GeorgeChiou/MiniPlan-V5/3D Mould Part/DOC/Print Part Group 12.JPG

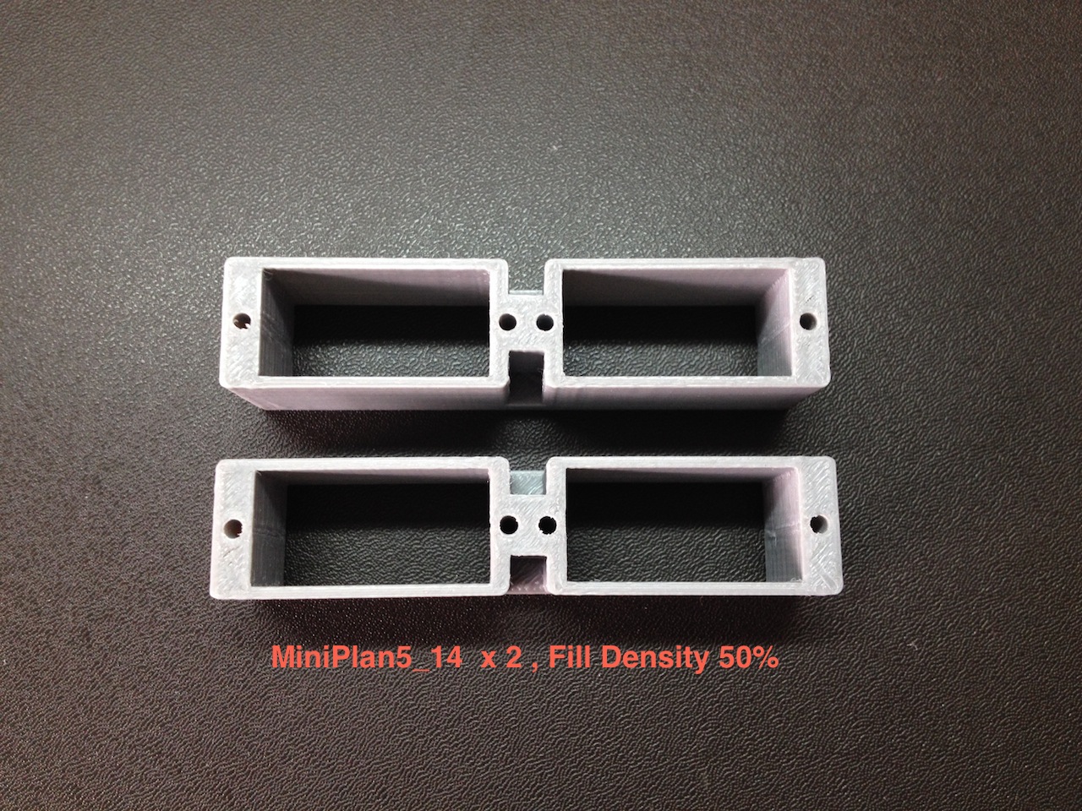
3D Mould Part/DOC/Print Part Group 12.JPG
