GeorgeChiou/MiniPlan-V5/3D Mould Part/DOC/MiniPlan v5.1 3DP for Iron Man.pdf

| 圖片 | 檔案名稱 | 數量
☐ | | MiniPlan5_10 | 14
☐ | | MiniPlan5_11 | 6
☐ | | MiniPlan5_12 | 1
☐ | | MiniPlan5_13 | 1
☐ | | MiniPlan5_14 | 2
☐ | | MiniPlan5_21 | 8
☐ | | MiniPlan5_25 | 2
☐ | | MiniPlan5_27 | 2
☐ | | MiniPlan5_30 | 1
☐ | | MiniPlan5_32 | 1
☐ | | MiniPlan5_40 | 1
☐ | | MiniPlan5_42 | 1
☐ | | MiniPlan5_43 | 1

☐ | MiniPlan5_50 | 1
☐ | MiniPlan5_51 | 1
☐ | MiniPlan51_20 | 8
☐ | MiniPlan51_22 | 4
☐ | MiniPlan51_23 | 2

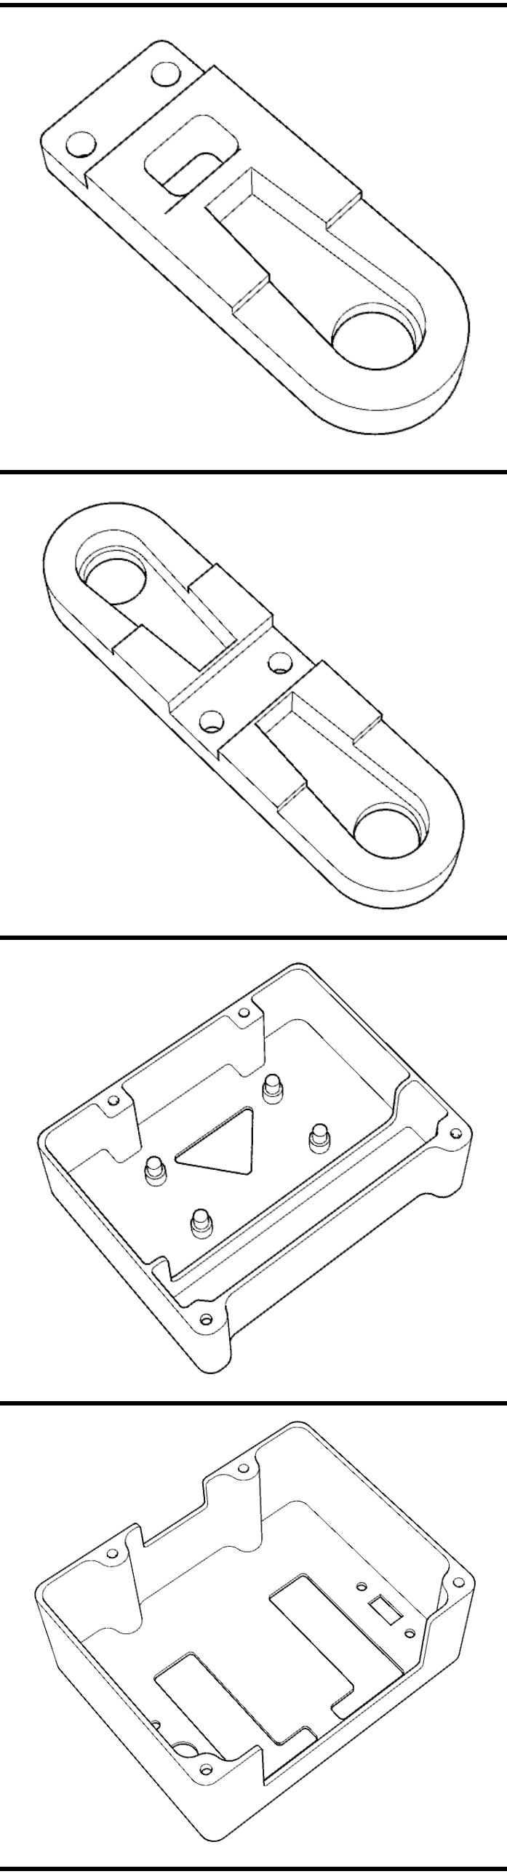
[picture p3: figure]

☐ | MiniPlan51_24 | 2
☐ | MiniPlan51_26 | 2
☐ | MiniPlan51_31_B | 1
☐ | MiniPlan51_34 | 1
☐ | MiniPlan51_60 | 1
☐ | MiniPlan51_61 | 1

☐ | MiniPlan51_70 | 2
☐ | MiniPlan51_71（透明材料） | 1
