GeorgeChiou/MiniPlan-V5/3D Mould Part/DOC/Arm.png

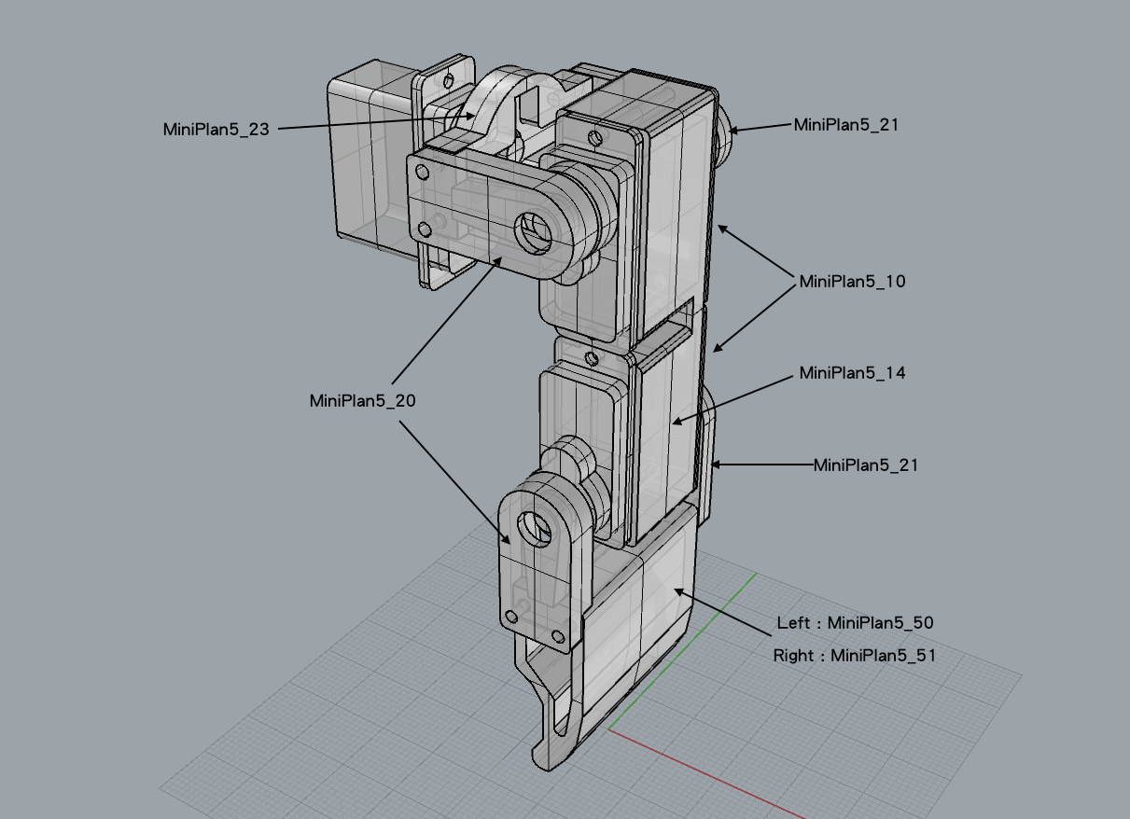
3D Mould Part/DOC/Arm.png
