GeorgeChiou/MiniPlan-V5/3D Mould Part/DOC/Body.png

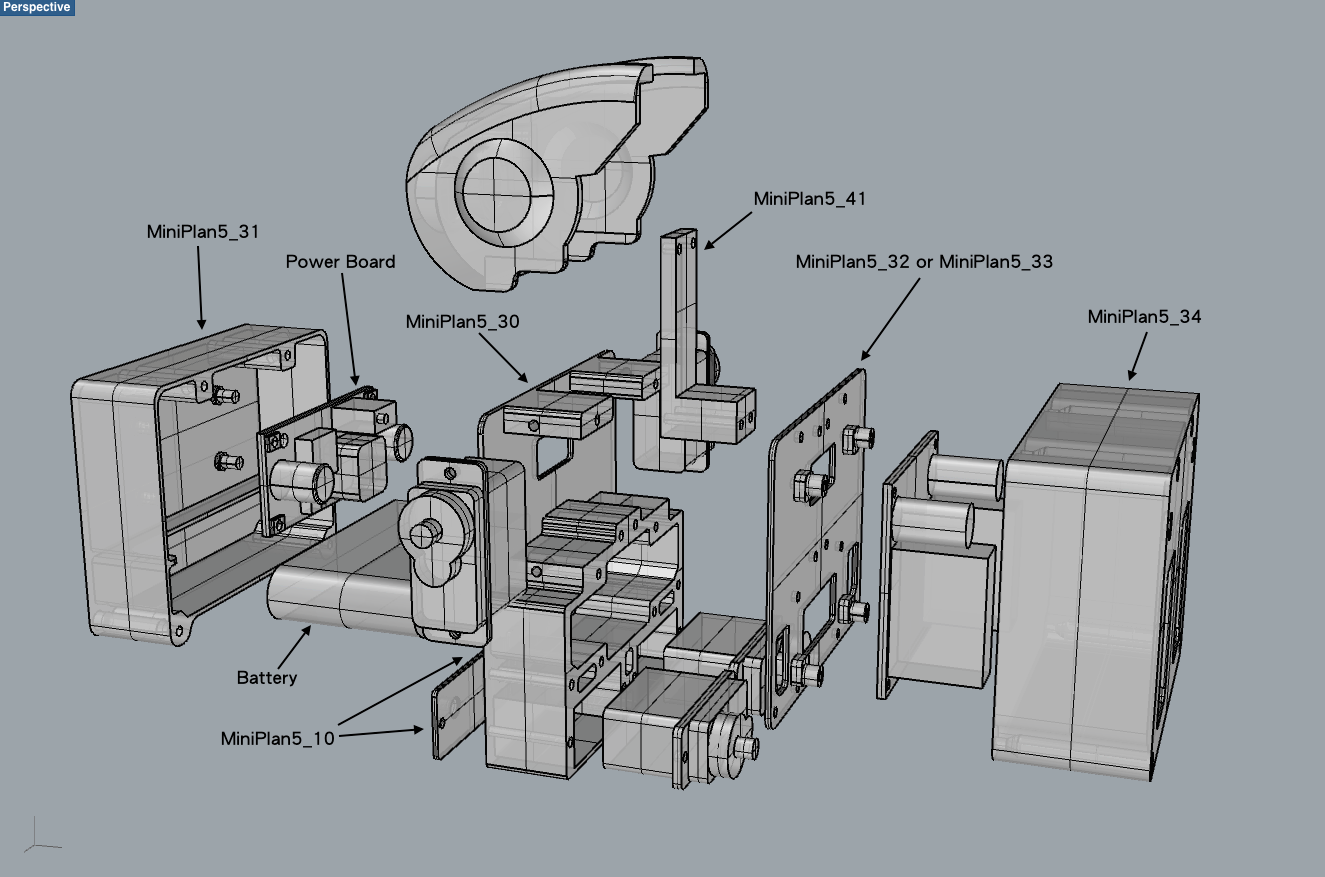
3D Mould Part/DOC/Body.png
