GeorgeChiou/MiniPlan-V5/3D Mould Part/DOC/CheckPart1.JPG

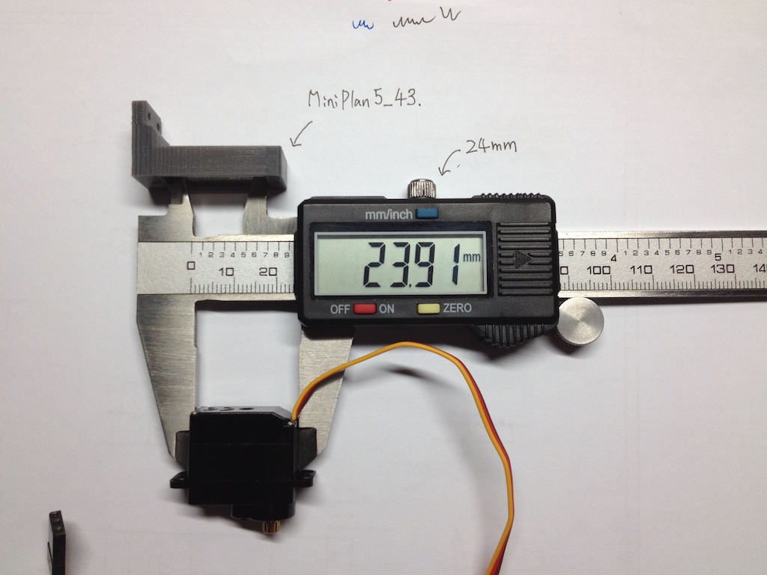
3D Mould Part/DOC/CheckPart1.JPG
