GeorgeChiou/MiniPlan-V5/3D Mould Part/DOC/CheckPart2.JPG

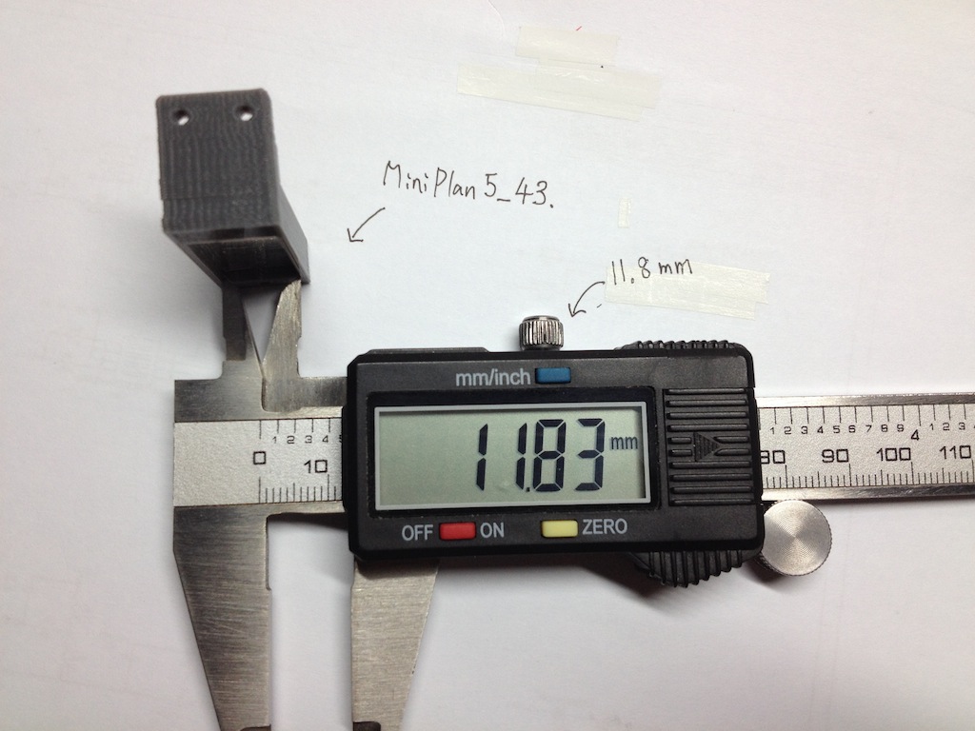
3D Mould Part/DOC/CheckPart2.JPG
