GeorgeChiou/MiniPlan-V5/3D Mould Part/DOC/Color Paint 1.png

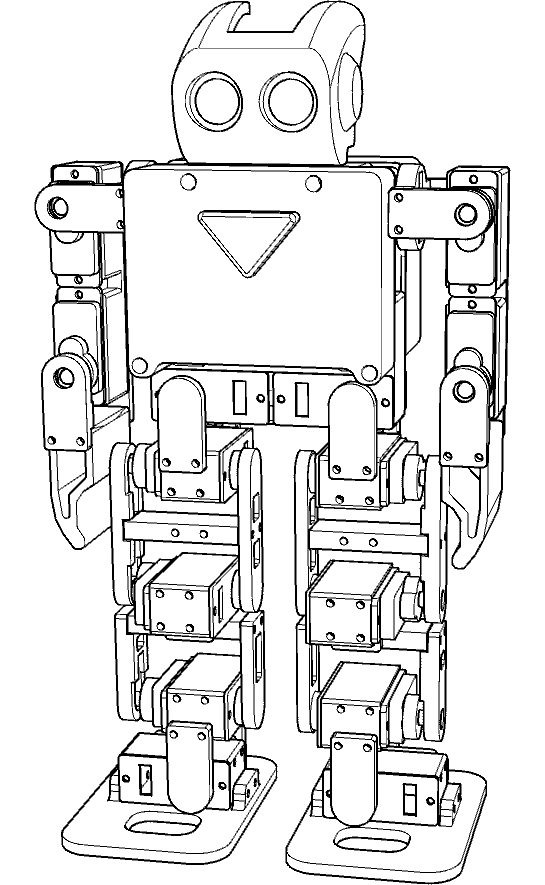
3D Mould Part/DOC/Color Paint 1.png
