GeorgeChiou/MiniPlan-V5/3D Mould Part/DOC/Color Paint 2.png

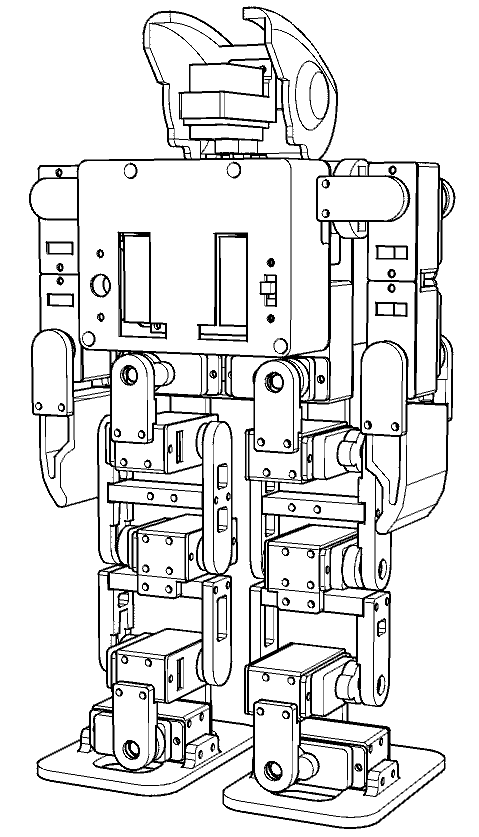
3D Mould Part/DOC/Color Paint 2.png
