GeorgeChiou/MiniPlan-V5/3D Mould Part/DOC/Cura 1.png

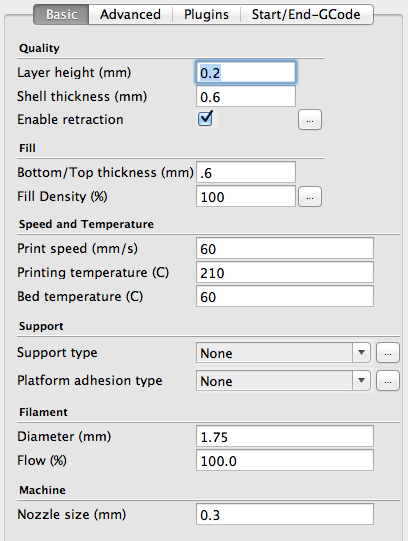
3D Mould Part/DOC/Cura 1.png
