GeorgeChiou/MiniPlan-V5/3D Mould Part/DOC/Cura 2.png

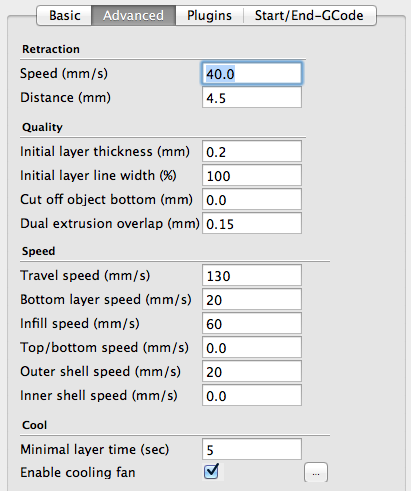
3D Mould Part/DOC/Cura 2.png
