GeorgeChiou/MiniPlan-V5/3D Mould Part/DOC/Head.png

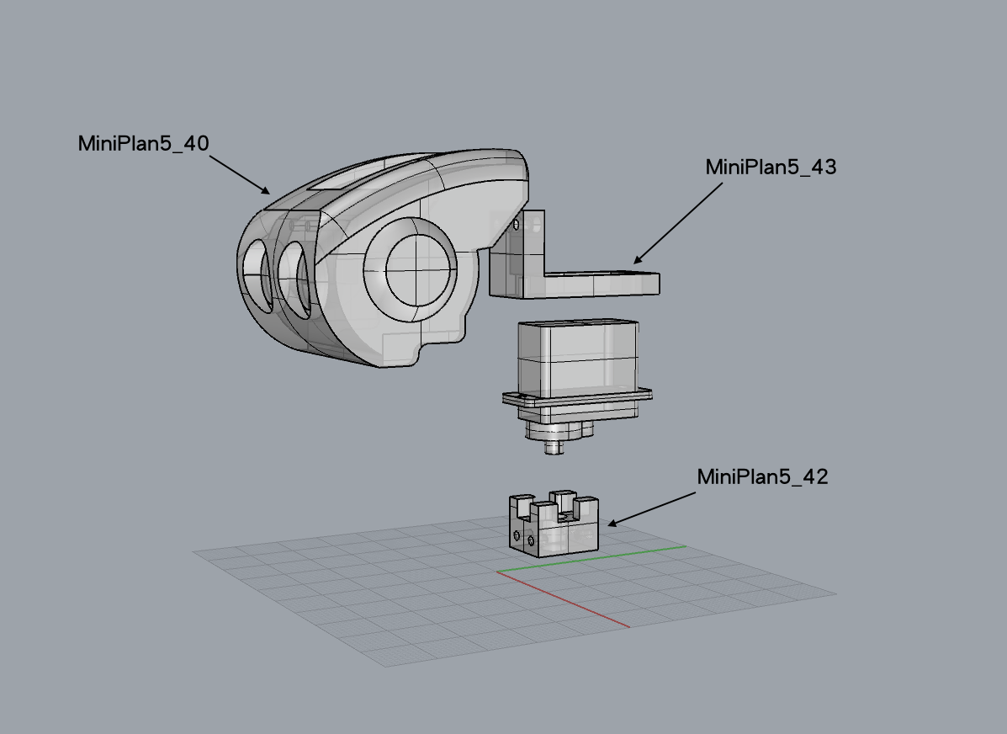
3D Mould Part/DOC/Head.png
