GeorgeChiou/MiniPlan-V5/3D Mould Part/DOC/Leg.png

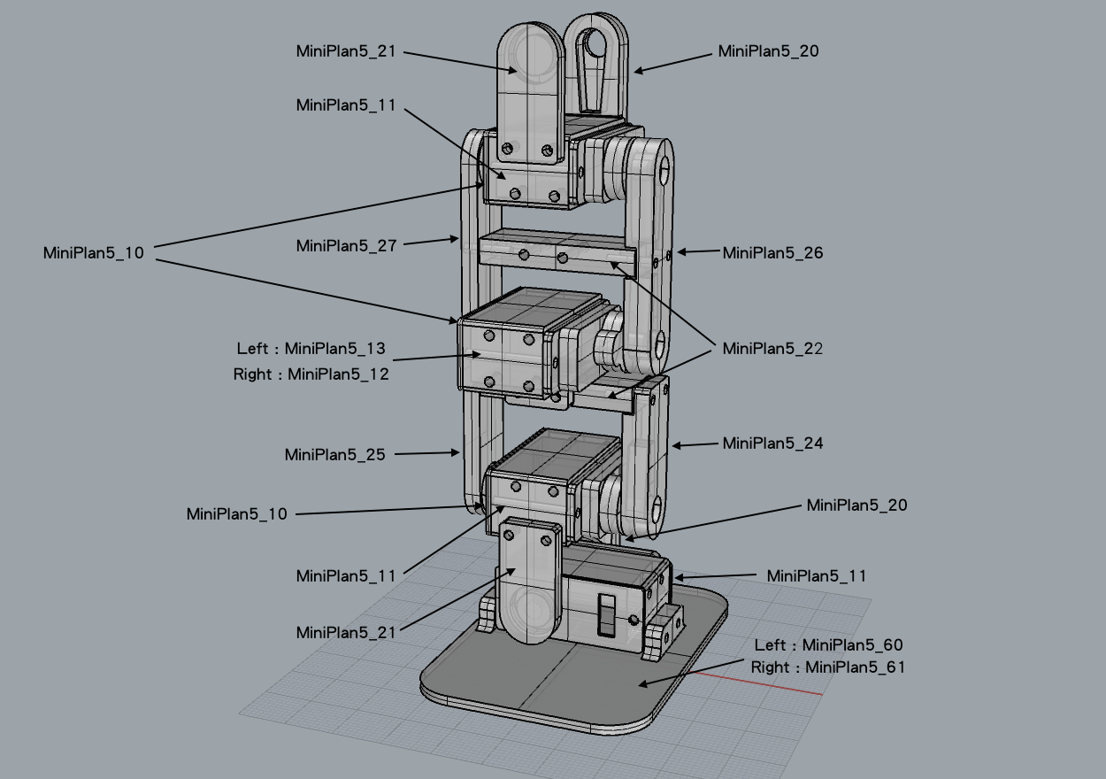
3D Mould Part/DOC/Leg.png
