GeorgeChiou/MiniPlan-V5/MiniPlan v5.1 HDK Part List.pdf

零件預覽 | 零件名稱 | 數量

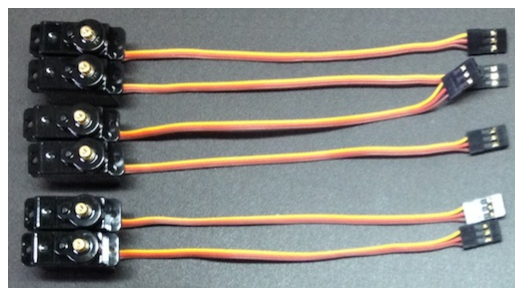
[picture p14: figure]

| 線長 13cm 伺服馬達 與配件包 | 6 包

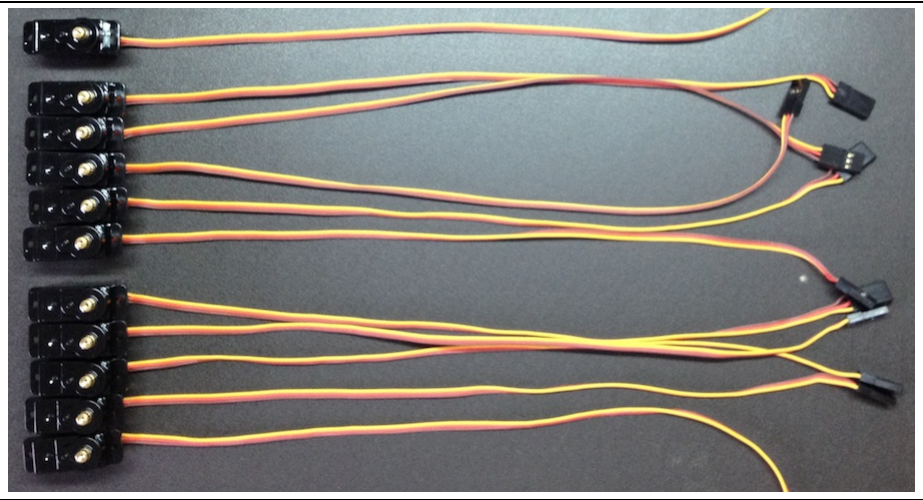
[picture p15: figure]

| 線長 25cm 伺服馬達 與配件包 | 11 包

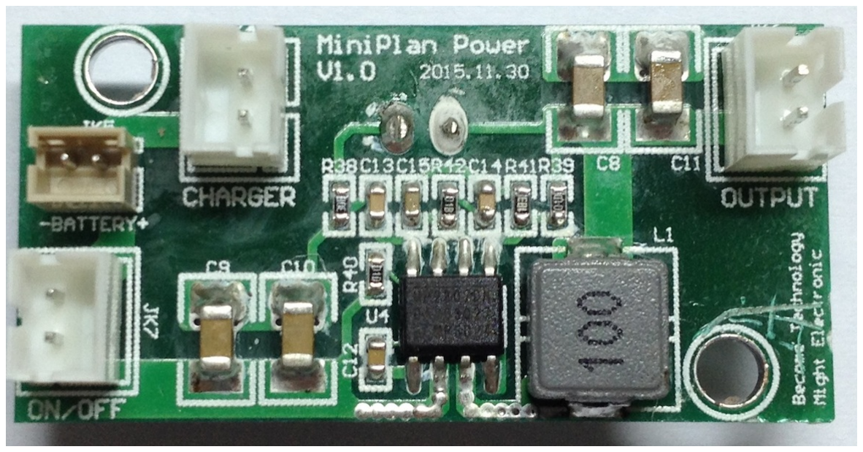
[picture p16: figure]

| 電源板 與 3mm LED | 1 片 1 顆

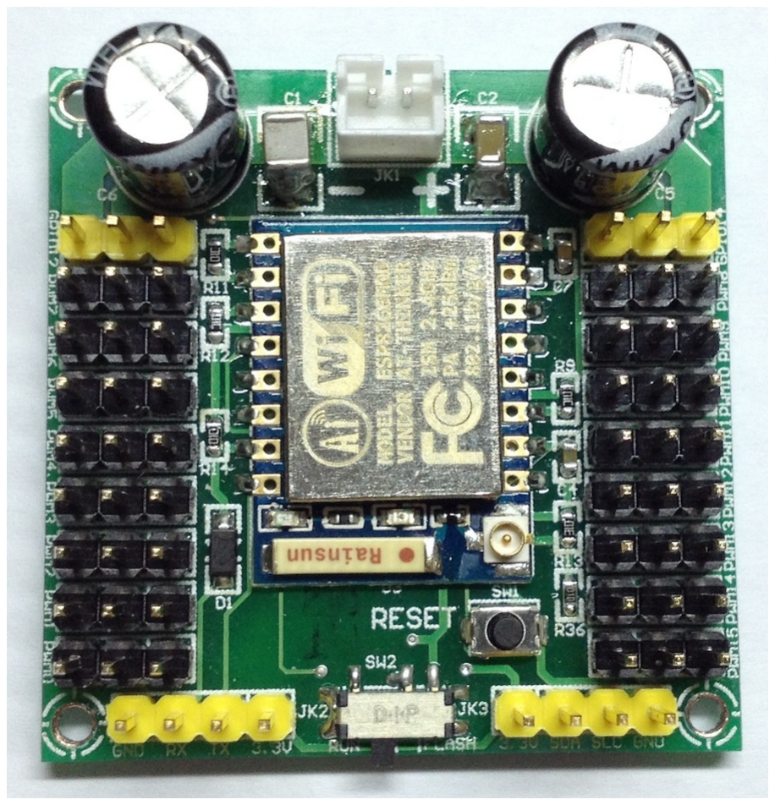
[picture p17: figure]

主控制板 | 1 片

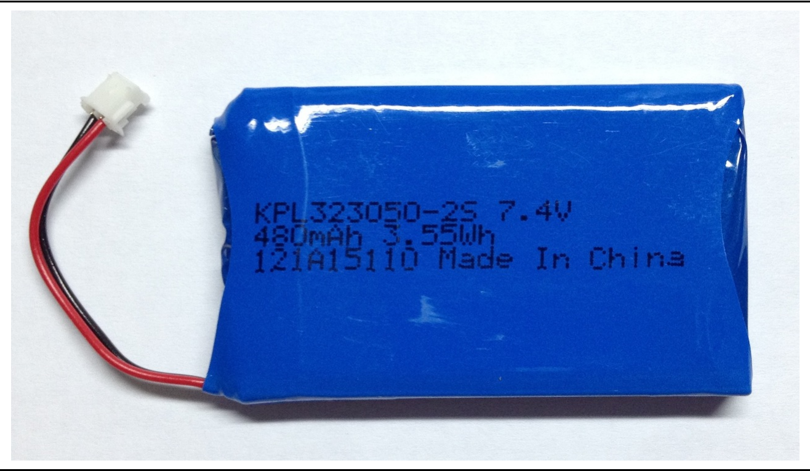
[picture p18: figure]

鋰電池 | 1 個

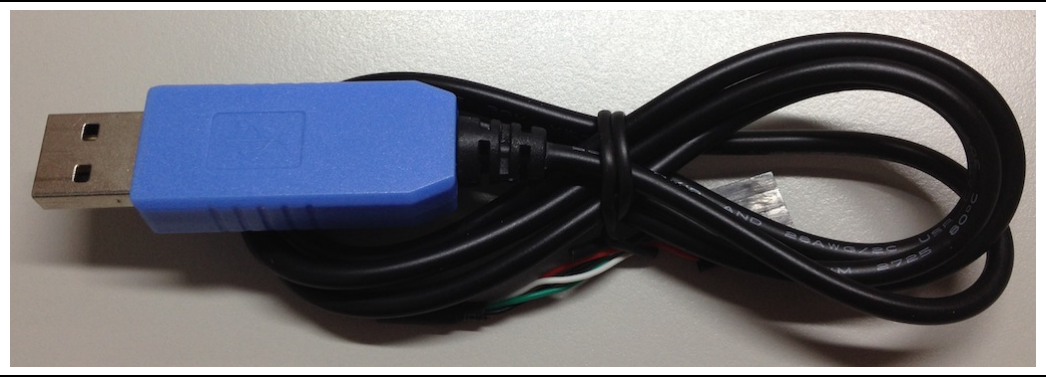
[picture p19: figure]

PL2303TA 電壓 3.3V TTL 傳輸線 USB to | 1 條

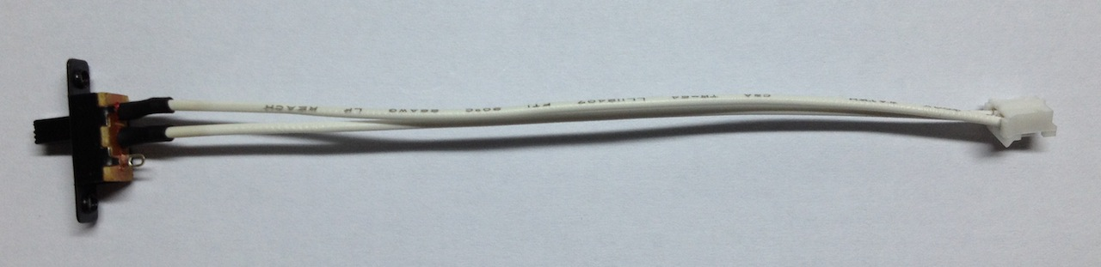
[picture p20: figure]

開關線組 | 1 條

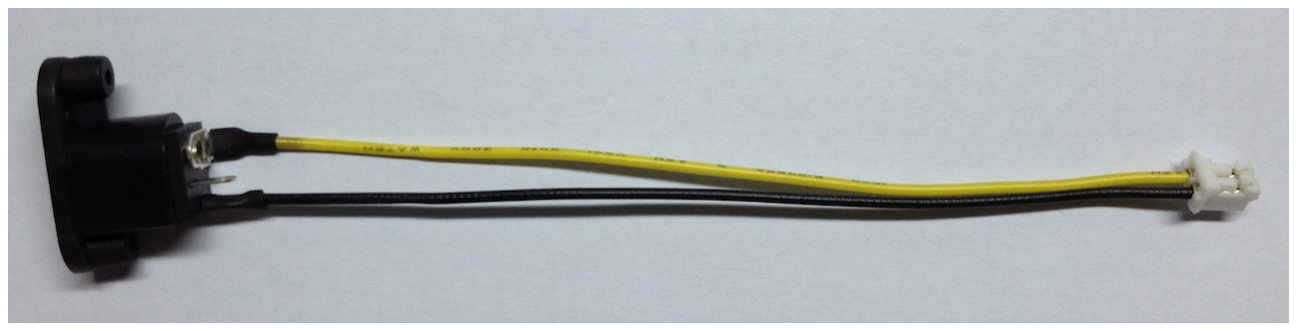
[picture p21: figure]

充電線組 | 1 條

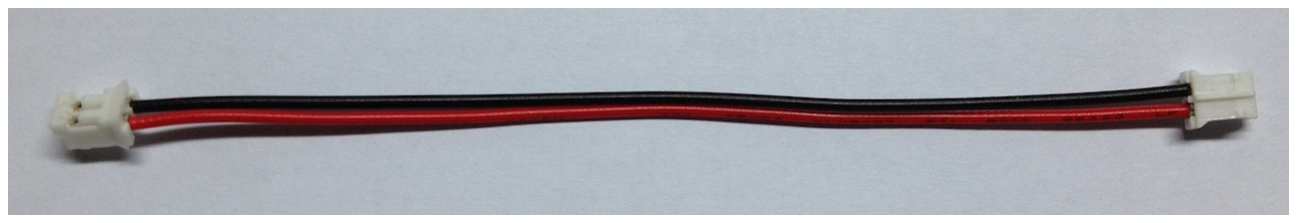
[picture p22: figure]

電源線組 | 1 條
培林 | 14 顆
8mm 自攻螺絲 2mm x | 200 顆
