GeorgeChiou/MiniPlan-V5/3D Mould Part/MiniPlan5_Leg_Assembly.stl

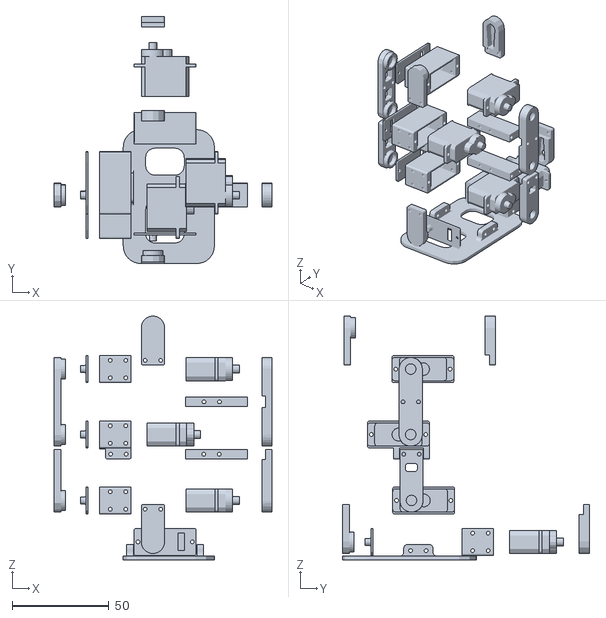
[picture p23: CAD file, 2018-02-11]
3D Mould Part/MiniPlan5_Leg_Assembly.stl
112.3 x 127.3 x 125.7
