GeorgeChiou/MiniPlan-V5/3D Mould Part/MiniPlan5_Head_Assembly_A.stl

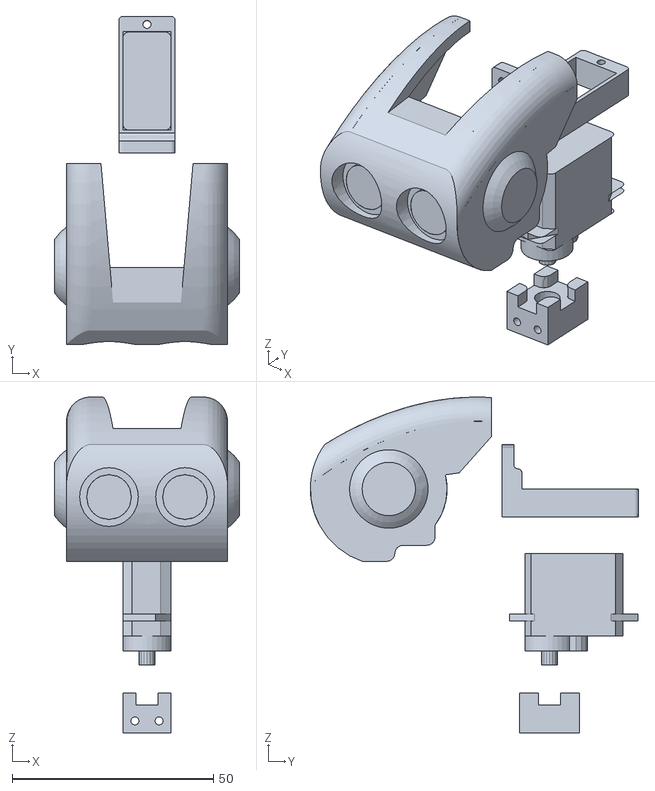
[picture p24: CAD file, 2018-02-11]
3D Mould Part/MiniPlan5_Head_Assembly_A.stl
46.0 x 81.6 x 83.5
