GeorgeChiou/MiniPlan-V5/3D Mould Part/MiniPlan5_Arm_FullAssembly.stl

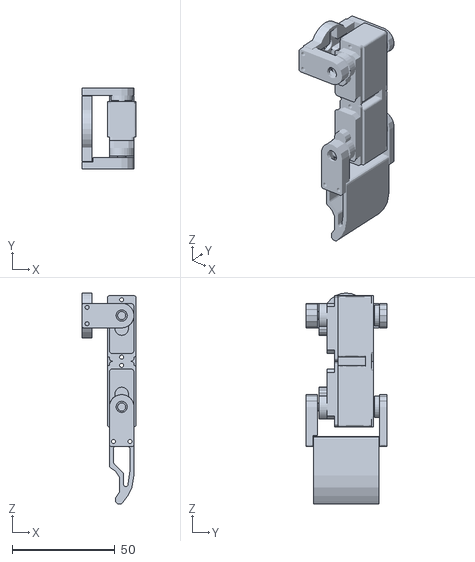
[picture p25: CAD file, 2018-02-11]
3D Mould Part/MiniPlan5_Arm_FullAssembly.stl
26.4 x 39.3 x 102.9
