GeorgeChiou/MiniPlan-V5/3D Mould Part/MiniPlan5_Arm_Assembly.stl

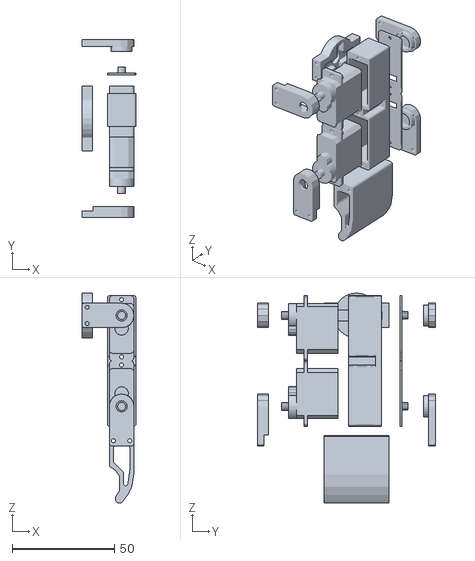
[picture p26: CAD file, 2018-02-11]
3D Mould Part/MiniPlan5_Arm_Assembly.stl
26.4 x 87.3 x 102.9
