GeorgeChiou/MiniPlan-V5/3D Mould Part/MiniPlan5_Body_Assembly.stl

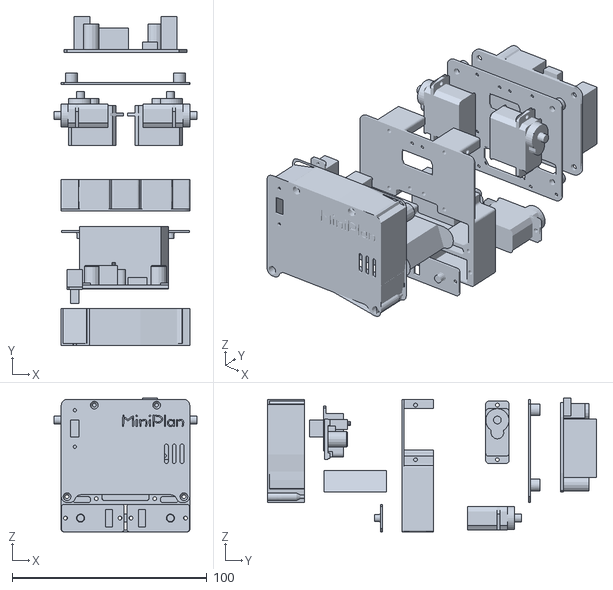
[picture p27: CAD file, 2018-02-11]
3D Mould Part/MiniPlan5_Body_Assembly.stl
73.4 x 168.9 x 68.5
