GeorgeChiou/MiniPlan-V5/3D Mould Part/MiniPlan5_Head_Assembly_B.stl

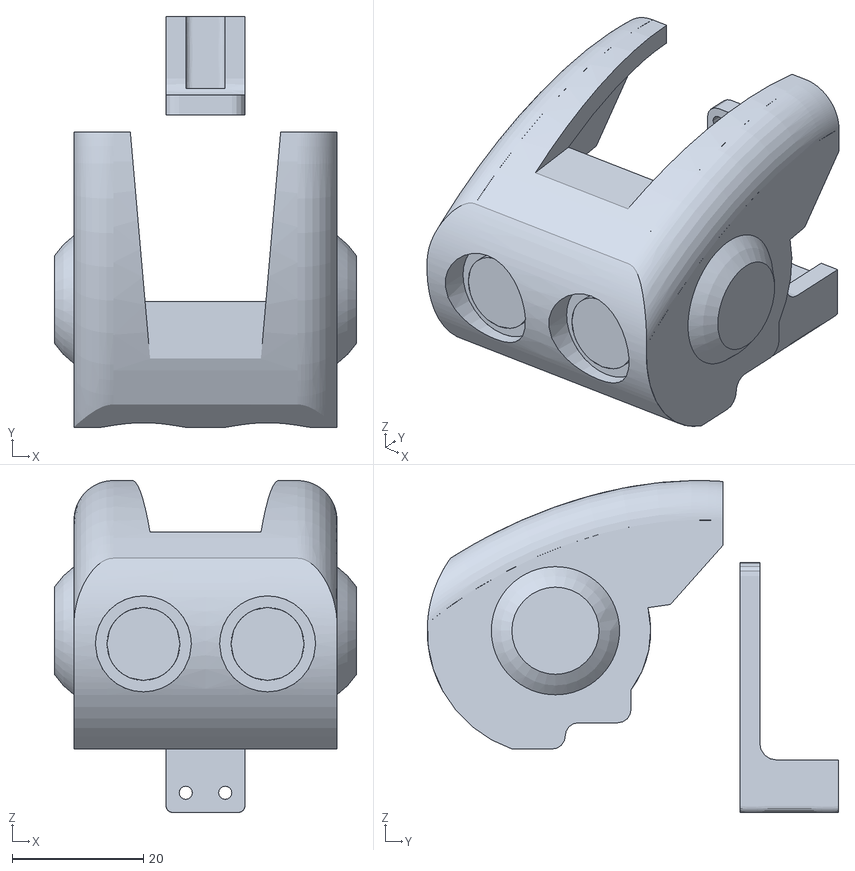
[picture p28: CAD file, 2018-02-11]
3D Mould Part/MiniPlan5_Head_Assembly_B.stl
46.0 x 62.6 x 50.5
