GeorgeChiou/MiniPlan-V5/3D Mould Part/MiniPlan5_Leg_FullAssembly.stl

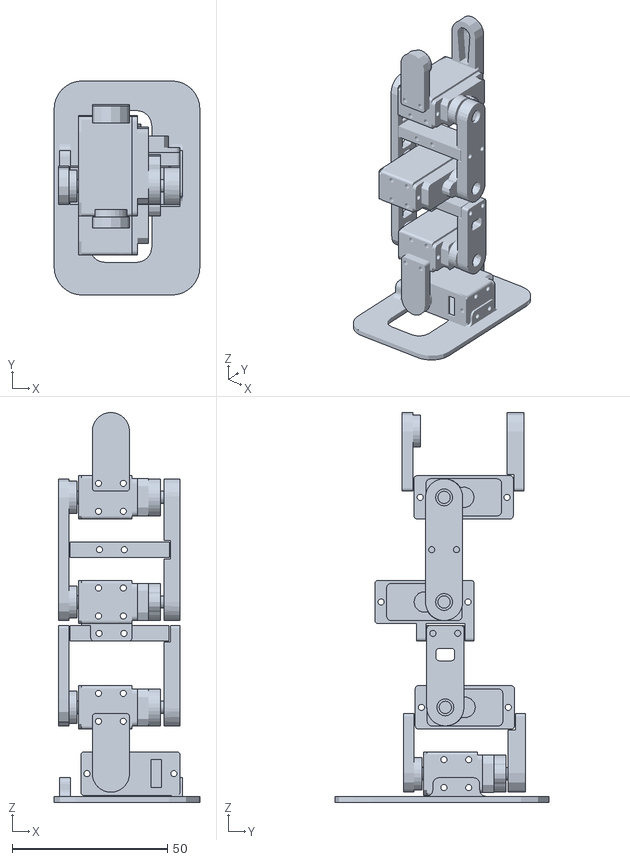
[picture p29: CAD file, 2018-02-11]
3D Mould Part/MiniPlan5_Leg_FullAssembly.stl
47.0 x 69.0 x 125.7
