GeorgeChiou/MiniPlan-V5/3D Mould Part/Arms Parts/MiniPlan5_50.stl

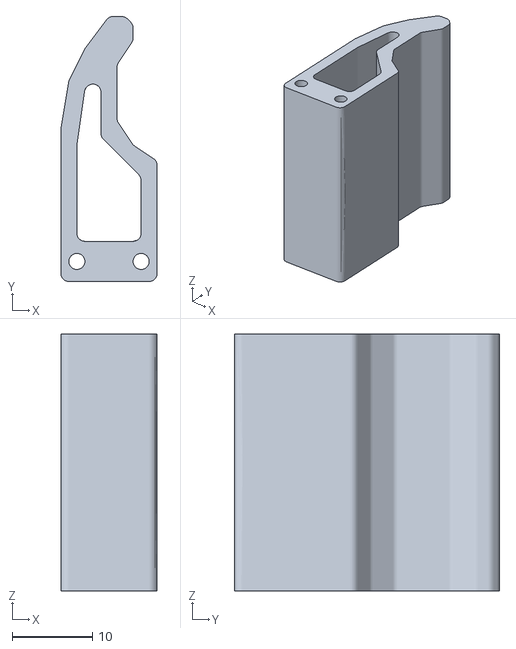
[picture p30: CAD file, 2018-02-11]
3D Mould Part/Arms Parts/MiniPlan5_50.stl
12.0 x 33.0 x 32.0
