GeorgeChiou/MiniPlan-V5/3D Mould Part/Body Parts/MiniPlan5_10.stl

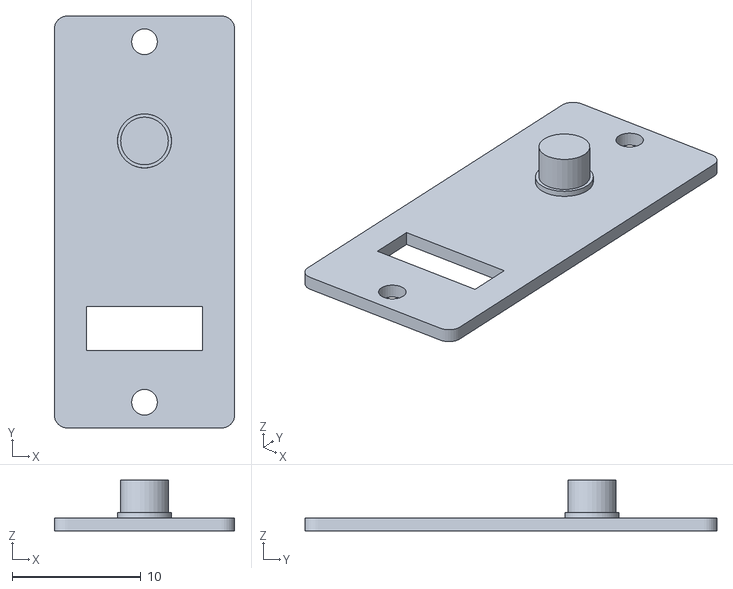
[picture p31: CAD file, 2018-02-11]
3D Mould Part/Body Parts/MiniPlan5_10.stl
14.0 x 32.0 x 3.95
