GeorgeChiou/MiniPlan-V5/3D Mould Part/Head Parts FIX/MiniPlan51_70.stl

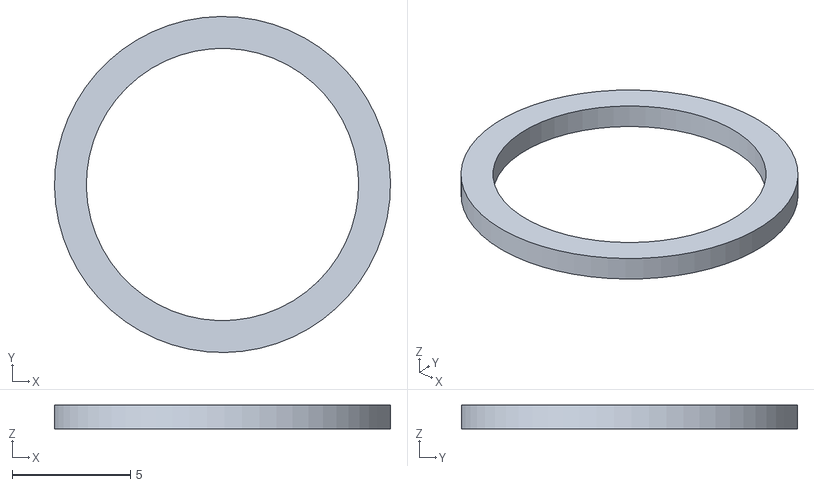
[picture p32: CAD file, 2018-02-11]
3D Mould Part/Head Parts FIX/MiniPlan51_70.stl
14.2 x 14.2 x 1.00
