GeorgeChiou/MiniPlan-V5/3D Mould Part/Head Parts MOVE/MiniPlan5_40.stl

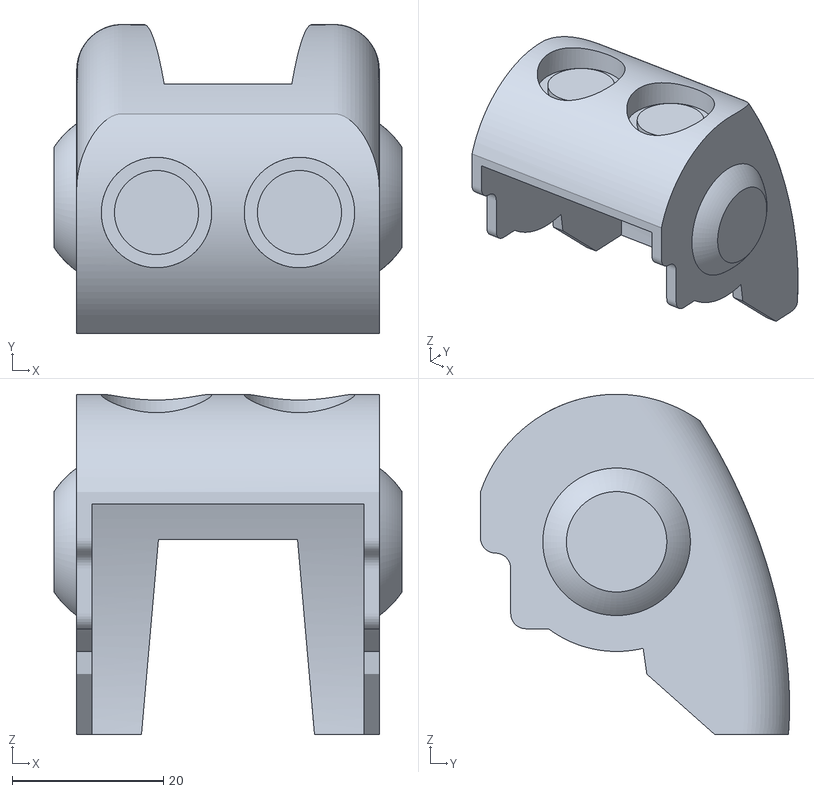
[picture p33: CAD file, 2018-02-11]
3D Mould Part/Head Parts MOVE/MiniPlan5_40.stl
46.0 x 40.9 x 45.0
