GeorgeChiou/MiniPlan-V5/3D Mould Part/Iron Man Body Parts/MiniPlan51_31_B.stl

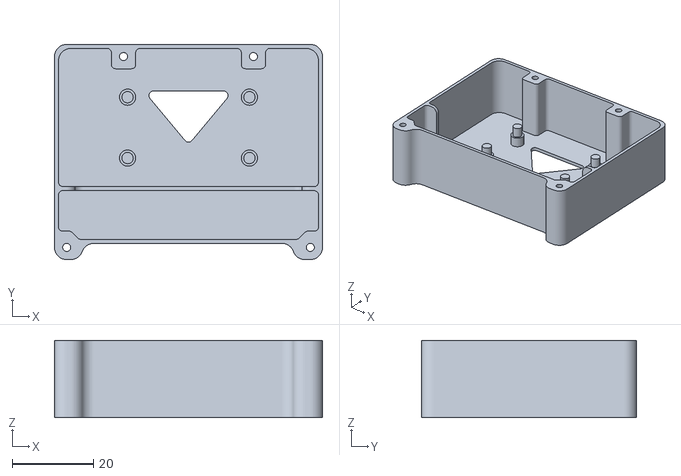
[picture p34: CAD file, 2018-02-11]
3D Mould Part/Iron Man Body Parts/MiniPlan51_31_B.stl
66.0 x 53.0 x 19.0
