GeorgeChiou/MiniPlan-V5/3D Mould Part/Left Leg Parts/MiniPlan51_24.stl

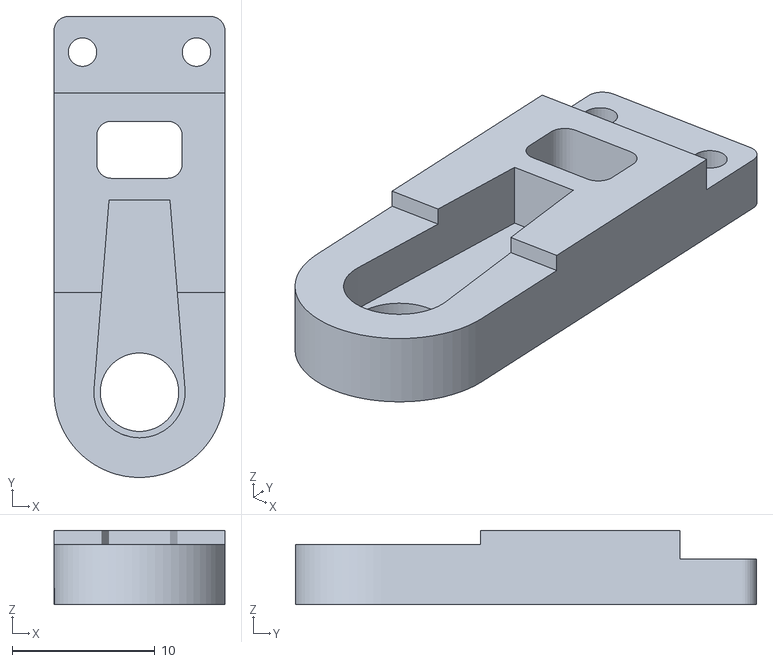
[picture p35: CAD file, 2018-02-11]
3D Mould Part/Left Leg Parts/MiniPlan51_24.stl
12.0 x 32.4 x 5.20
