GeorgeChiou/MiniPlan-V5/3D Mould Part/Right Leg Parts/MiniPlan51_20.stl

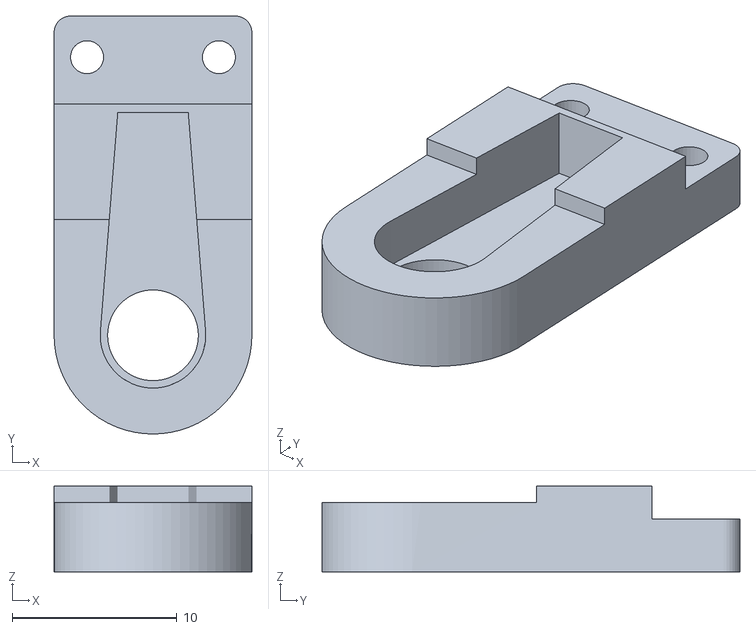
[picture p36: CAD file, 2018-02-11]
3D Mould Part/Right Leg Parts/MiniPlan51_20.stl
12.0 x 25.4 x 5.20
