GeorgeChiou/MiniPlan-V5/3D Mould Part/Arms Parts/MiniPlan5_14.stl

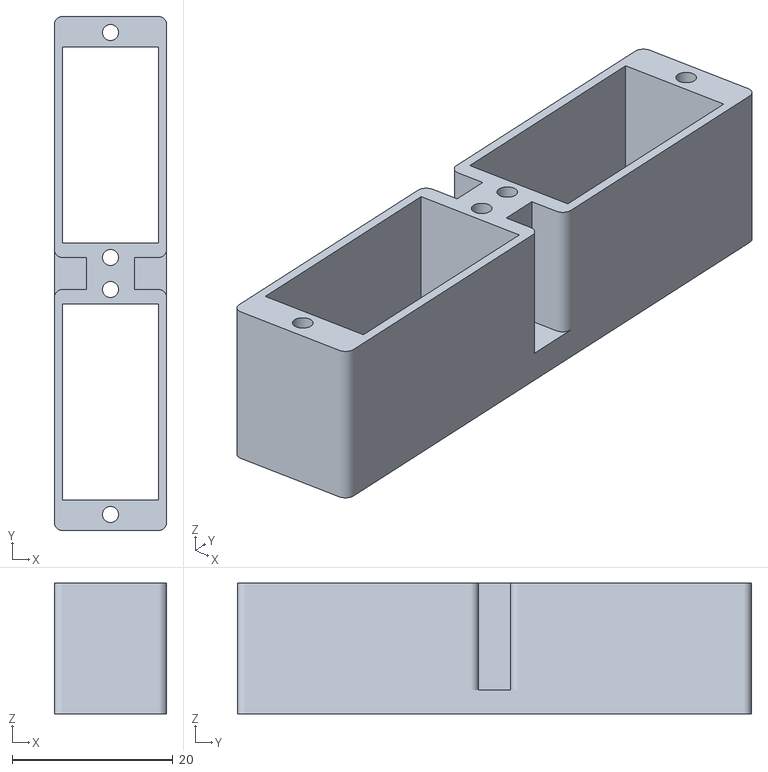
[picture p37: CAD file, 2018-02-11]
3D Mould Part/Arms Parts/MiniPlan5_14.stl
14.0 x 64.0 x 16.3
