GeorgeChiou/MiniPlan-V5/3D Mould Part/Body Parts/MiniPlan5_32.stl

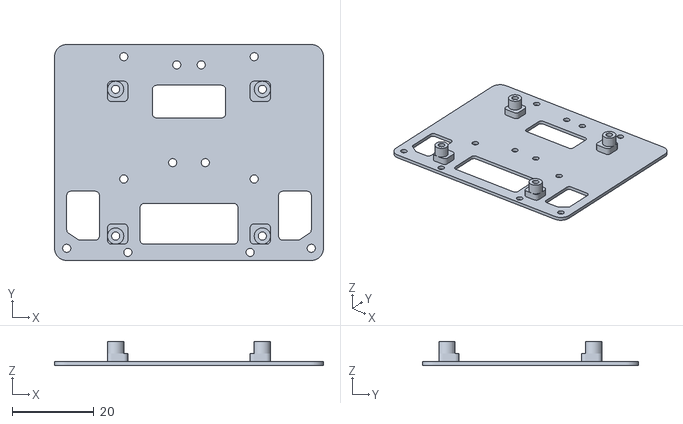
[picture p38: CAD file, 2018-02-11]
3D Mould Part/Body Parts/MiniPlan5_32.stl
66.0 x 53.0 x 6.00
