GeorgeChiou/MiniPlan-V5/3D Mould Part/Head Parts FIX/MiniPlan5_41.stl

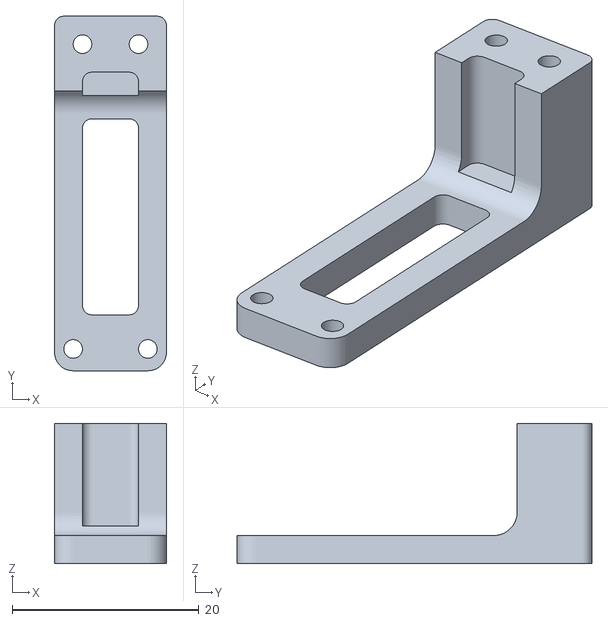
[picture p39: CAD file, 2018-02-11]
3D Mould Part/Head Parts FIX/MiniPlan5_41.stl
12.0 x 38.0 x 15.0
