GeorgeChiou/MiniPlan-V5/3D Mould Part/Right Leg Parts/MiniPlan51_61.stl

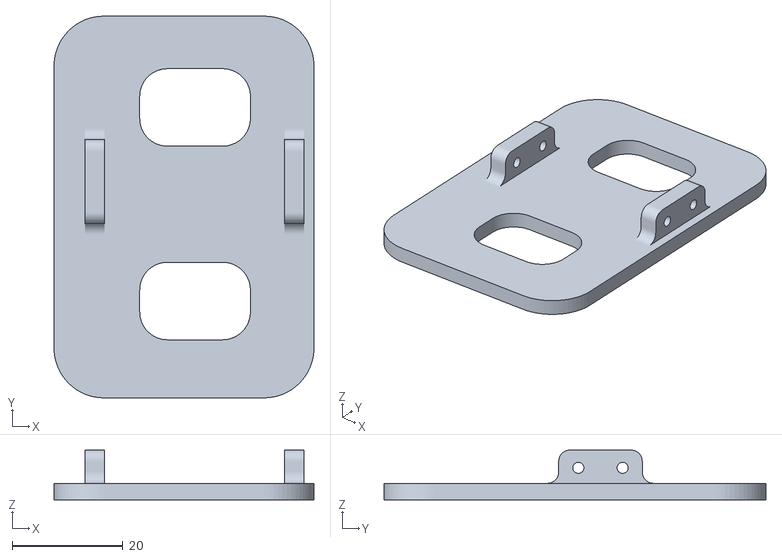
[picture p41: CAD file, 2018-02-11]
3D Mould Part/Right Leg Parts/MiniPlan51_61.stl
47.0 x 69.0 x 9.00
