GeorgeChiou/MiniPlan-V5/3D Mould Part/Body Parts/MiniPlan5_33.stl

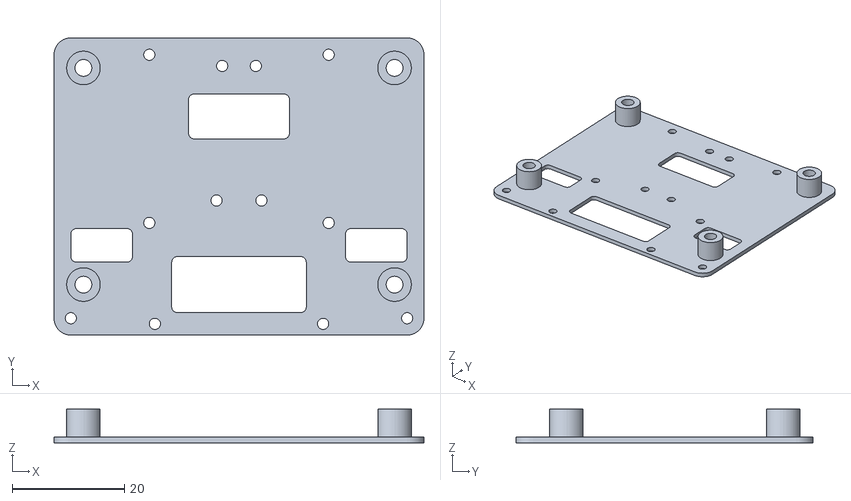
[picture p42: CAD file, 2018-02-11]
3D Mould Part/Body Parts/MiniPlan5_33.stl
66.0 x 53.0 x 6.00
