GeorgeChiou/MiniPlan-V5/3D Mould Part/Head Parts MOVE/MiniPlan5_43.stl

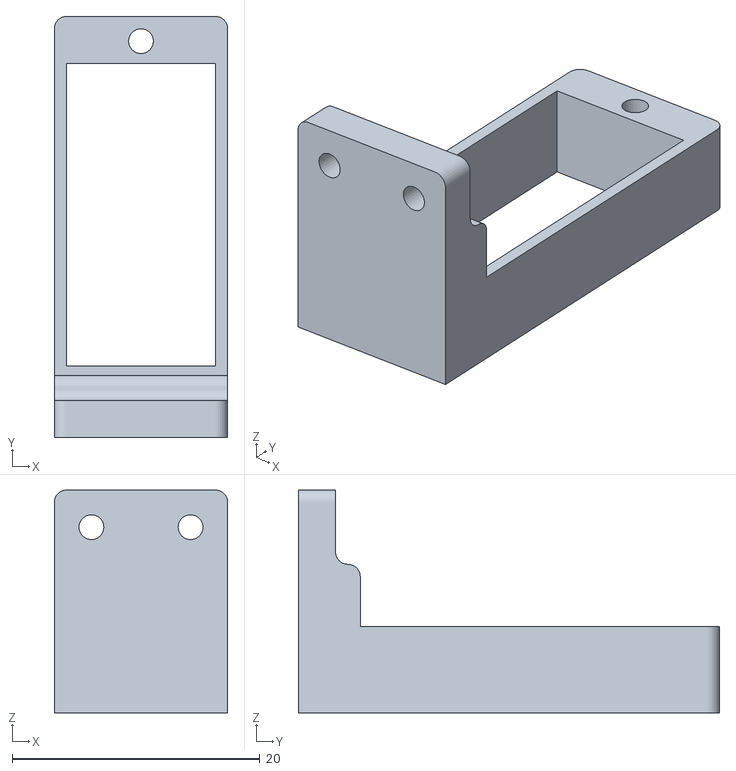
[picture p43: CAD file, 2018-02-11]
3D Mould Part/Head Parts MOVE/MiniPlan5_43.stl
14.0 x 34.0 x 18.0
