GeorgeChiou/MiniPlan-V5/3D Mould Part/Iron Man Body Parts/MiniPlan51_71.stl

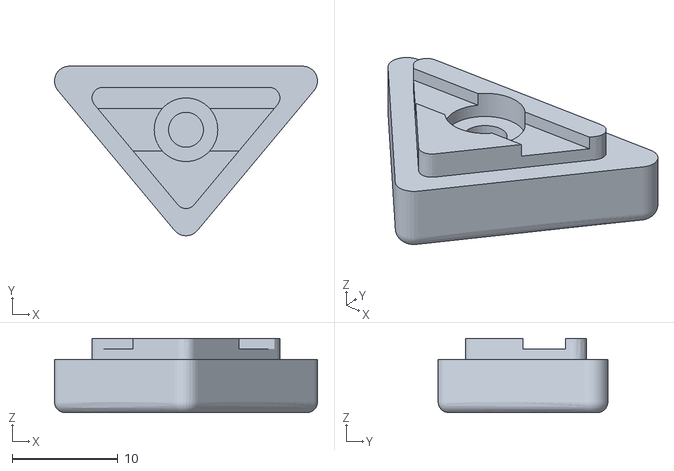
[picture p44: CAD file, 2018-02-11]
3D Mould Part/Iron Man Body Parts/MiniPlan51_71.stl
24.8 x 16.0 x 7.00
