GeorgeChiou/MiniPlan-V5/3D Mould Part/Left Leg Parts/MiniPlan5_11.stl

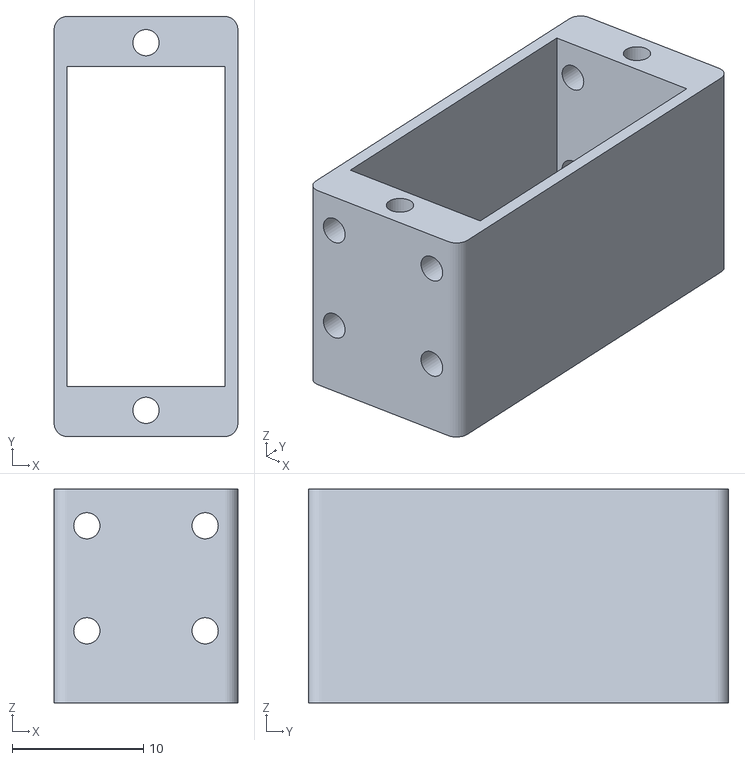
[picture p45: CAD file, 2018-02-11]
3D Mould Part/Left Leg Parts/MiniPlan5_11.stl
14.0 x 32.0 x 16.3
