GeorgeChiou/MiniPlan-V5/3D Mould Part/Right Leg Parts/MiniPlan51_26.stl

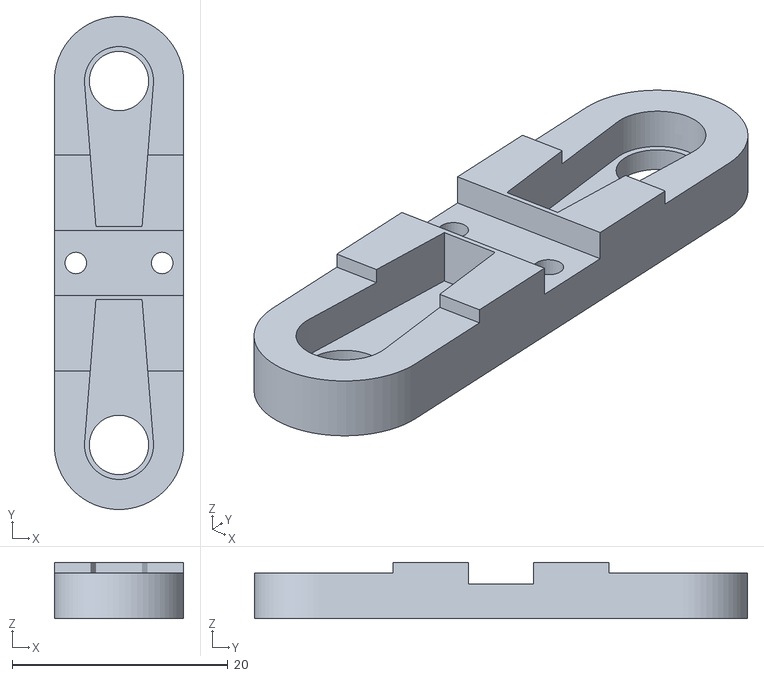
[picture p46: CAD file, 2018-02-11]
3D Mould Part/Right Leg Parts/MiniPlan51_26.stl
12.0 x 45.7 x 5.20
