GeorgeChiou/MiniPlan-V5/3D Mould Part/Body Parts/MiniPlan5_30.stl

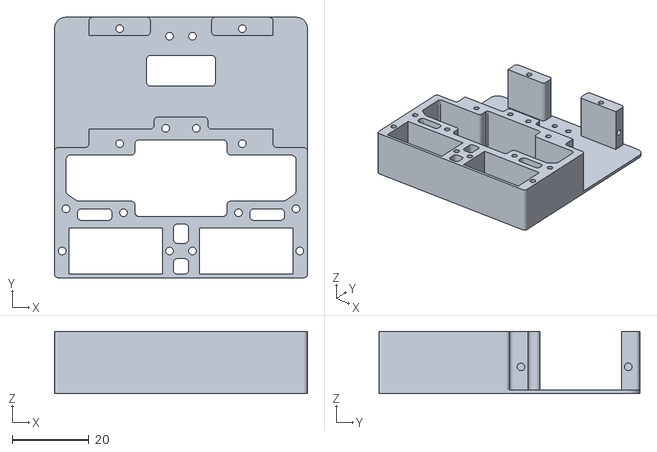
[picture p47: CAD file, 2018-02-11]
3D Mould Part/Body Parts/MiniPlan5_30.stl
66.0 x 68.0 x 16.3
