GeorgeChiou/MiniPlan-V5/3D Mould Part/Head Parts MOVE/MiniPlan5_42.stl

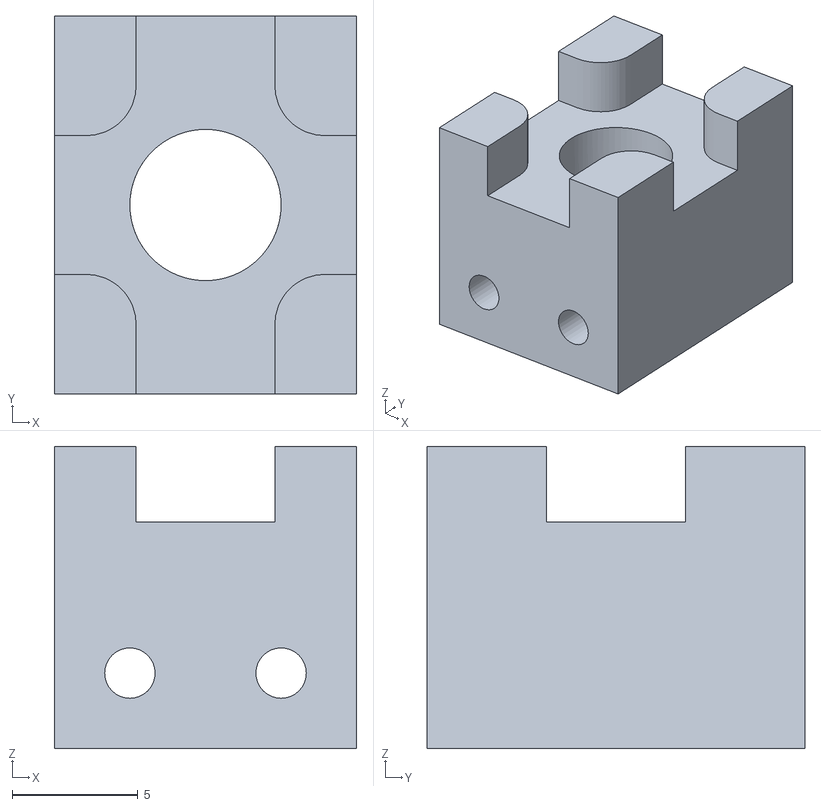
[picture p48: CAD file, 2018-02-11]
3D Mould Part/Head Parts MOVE/MiniPlan5_42.stl
12.0 x 15.0 x 12.0
