GeorgeChiou/MiniPlan-V5/3D Mould Part/Iron Man Body Parts/MiniPlan51_34.stl

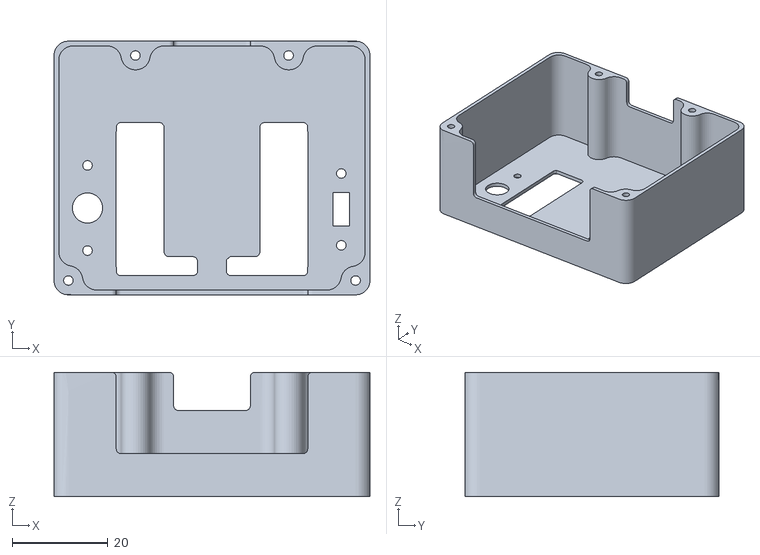
[picture p49: CAD file, 2018-02-11]
3D Mould Part/Iron Man Body Parts/MiniPlan51_34.stl
66.0 x 53.0 x 26.0
