GeorgeChiou/MiniPlan-V5/3D Mould Part/Left Leg Parts/MiniPlan5_27.stl

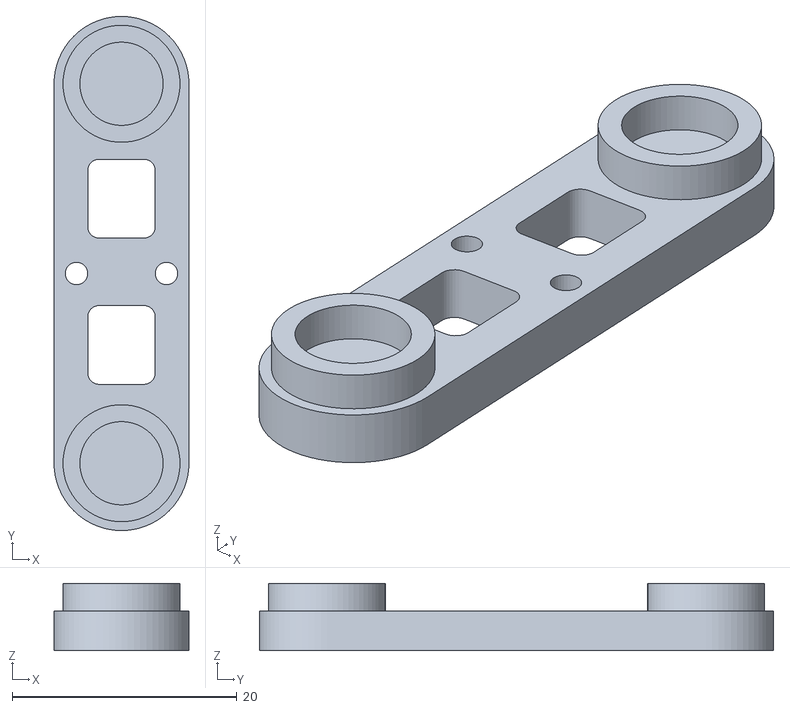
[picture p50: CAD file, 2018-02-11]
3D Mould Part/Left Leg Parts/MiniPlan5_27.stl
12.0 x 45.7 x 5.97
