GeorgeChiou/MiniPlan-V5/3D Mould Part/Right Leg Parts/MiniPlan5_12.stl

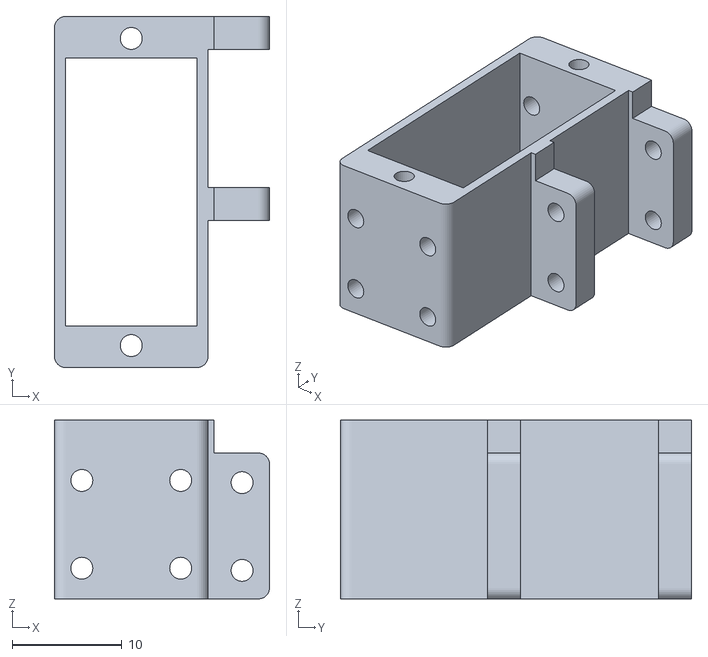
[picture p51: CAD file, 2018-02-11]
3D Mould Part/Right Leg Parts/MiniPlan5_12.stl
19.6 x 32.0 x 16.3
