GeorgeChiou/MiniPlan-V5/3D Mould Part/Arms Parts/MiniPlan51_23.stl

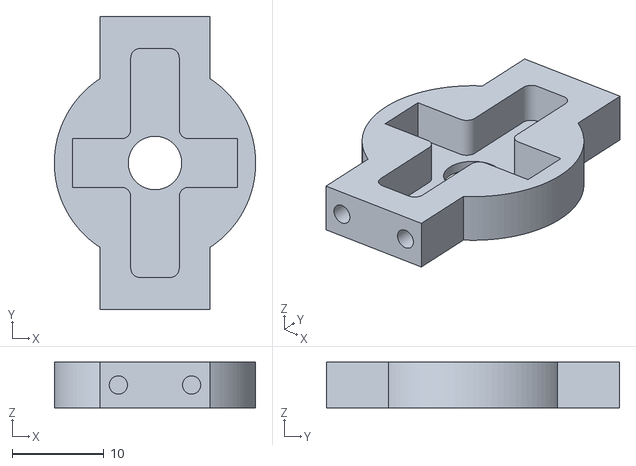
[picture p52: CAD file, 2018-02-11]
3D Mould Part/Arms Parts/MiniPlan51_23.stl
22.0 x 32.0 x 5.00
