GeorgeChiou/MiniPlan-V5/3D Mould Part/Iron Man Body Parts/MiniPlan51_31_GIF.stl

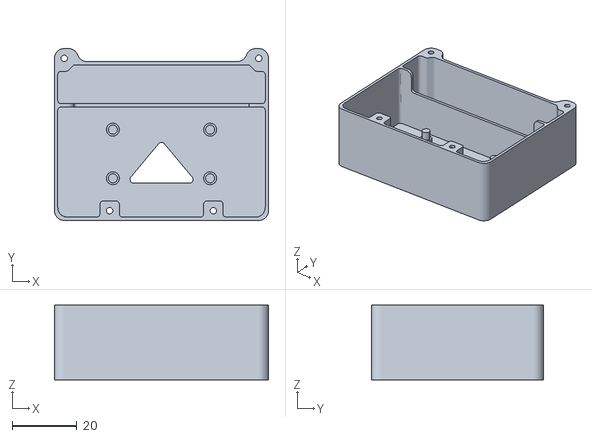
[picture p53: CAD file, 2018-02-11]
3D Mould Part/Iron Man Body Parts/MiniPlan51_31_GIF.stl
66.0 x 53.0 x 23.0
