GeorgeChiou/MiniPlan-V5/3D Mould Part/Right Leg Parts/MiniPlan5_21.stl

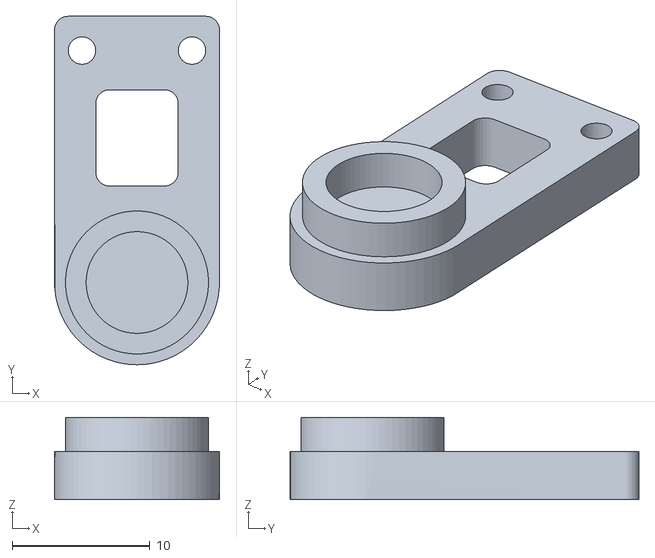
[picture p54: CAD file, 2018-02-11]
3D Mould Part/Right Leg Parts/MiniPlan5_21.stl
12.0 x 25.4 x 5.97
