GeorgeChiou/MiniPlan-V5/3D Mould Part/Left Leg Parts/MiniPlan5_25.stl

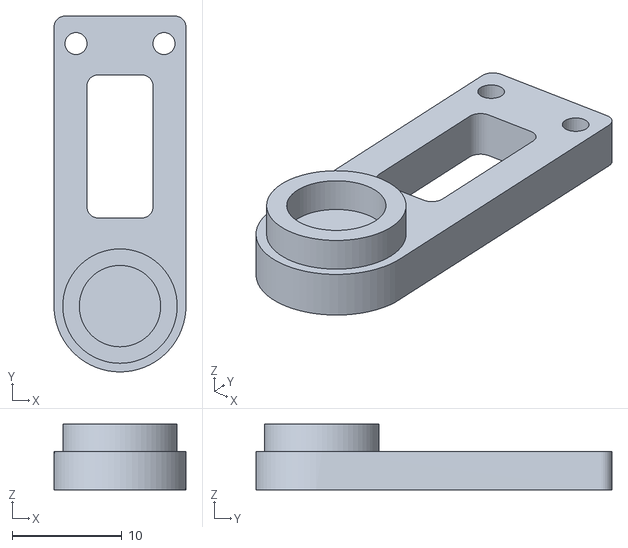
[picture p55: CAD file, 2018-02-11]
3D Mould Part/Left Leg Parts/MiniPlan5_25.stl
12.0 x 32.4 x 5.97
