GeorgeChiou/MiniPlan-V5/(list of files, cad)

Other CAD files:
3D Mould Part/Body Parts/MiniPlan51_31_A.stl
3D Mould Part/Left Leg Parts/MiniPlan5_13.stl
3D Mould Part/Arms Parts/MiniPlan5_51.stl
3D Mould Part/Body Parts/MiniPlan51_31_C.stl
3D Mould Part/Left Leg Parts/MiniPlan51_60.stl
3D Mould Part/Arms Parts/MiniPlan51_20.obj
3D Mould Part/Arms Parts/MiniPlan51_23.obj
3D Mould Part/Arms Parts/MiniPlan5_10.obj
3D Mould Part/Arms Parts/MiniPlan5_14.obj
3D Mould Part/Arms Parts/MiniPlan5_21.obj
3D Mould Part/Arms Parts/MiniPlan5_50.obj
3D Mould Part/Arms Parts/MiniPlan5_51.obj
3D Mould Part/Body Parts/MiniPlan51_31_A.obj
3D Mould Part/Body Parts/MiniPlan51_31_C.obj
3D Mould Part/Body Parts/MiniPlan51_34.obj
3D Mould Part/Body Parts/MiniPlan5_10.obj
3D Mould Part/Body Parts/MiniPlan5_30.obj
3D Mould Part/Body Parts/MiniPlan5_32.obj
3D Mould Part/Body Parts/MiniPlan5_33.obj
3D Mould Part/Head Parts FIX/MiniPlan51_70.obj
3D Mould Part/Head Parts FIX/MiniPlan5_40.obj
3D Mould Part/Head Parts FIX/MiniPlan5_41.obj
3D Mould Part/Head Parts MOVE/MiniPlan51_70.obj
3D Mould Part/Head Parts MOVE/MiniPlan5_40.obj
3D Mould Part/Head Parts MOVE/MiniPlan5_42.obj
3D Mould Part/Head Parts MOVE/MiniPlan5_43.obj
3D Mould Part/Iron Man Body Parts/MiniPlan51_31_B.obj
3D Mould Part/Iron Man Body Parts/MiniPlan51_31_GIF.obj
3D Mould Part/Iron Man Body Parts/MiniPlan51_34.obj
3D Mould Part/Iron Man Body Parts/MiniPlan51_71.obj
3D Mould Part/Iron Man Body Parts/MiniPlan5_10.obj
3D Mould Part/Iron Man Body Parts/MiniPlan5_30.obj
3D Mould Part/Iron Man Body Parts/MiniPlan5_32.obj
3D Mould Part/Left Leg Parts/MiniPlan51_20.obj
3D Mould Part/Left Leg Parts/MiniPlan51_22.obj
3D Mould Part/Left Leg Parts/MiniPlan51_24.obj
3D Mould Part/Left Leg Parts/MiniPlan51_26.obj
3D Mould Part/Left Leg Parts/MiniPlan51_60.obj
3D Mould Part/Left Leg Parts/MiniPlan5_10.obj
3D Mould Part/Left Leg Parts/MiniPlan5_11.obj
3D Mould Part/Left Leg Parts/MiniPlan5_13.obj
3D Mould Part/Left Leg Parts/MiniPlan5_21.obj
3D Mould Part/Left Leg Parts/MiniPlan5_25.obj
3D Mould Part/Left Leg Parts/MiniPlan5_27.obj
3D Mould Part/Right Leg Parts/MiniPlan51_20.obj
3D Mould Part/Right Leg Parts/MiniPlan51_22.obj
3D Mould Part/Right Leg Parts/MiniPlan51_24.obj
3D Mould Part/Right Leg Parts/MiniPlan51_26.obj
3D Mould Part/Right Leg Parts/MiniPlan51_61.obj
3D Mould Part/Right Leg Parts/MiniPlan5_10.obj
3D Mould Part/Right Leg Parts/MiniPlan5_11.obj
3D Mould Part/Right Leg Parts/MiniPlan5_12.obj
3D Mould Part/Right Leg Parts/MiniPlan5_21.obj
3D Mould Part/Right Leg Parts/MiniPlan5_25.obj
3D Mould Part/Right Leg Parts/MiniPlan5_27.obj
