GeorgeChiou/MiniPlan-V5/3D Mould Part/DOC/MiniPlan5_40_Print_2.jpg

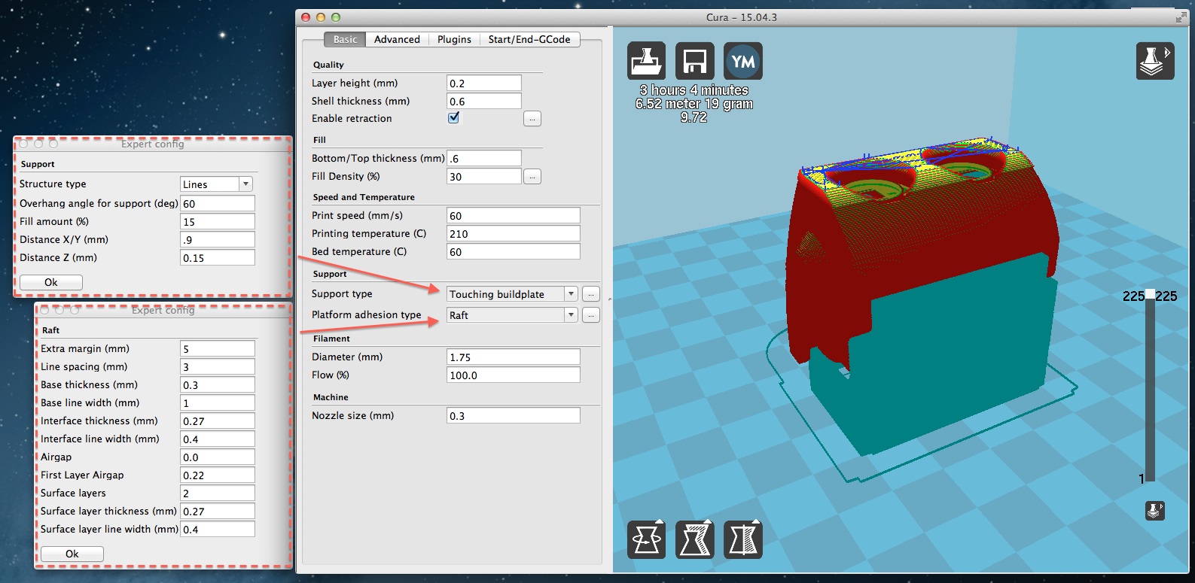
3D Mould Part/DOC/MiniPlan5_40_Print_2.jpg
