GeorgeChiou/MiniPlan-V5/3D Mould Part/DOC/Print Part Group 1B.JPG.JPG

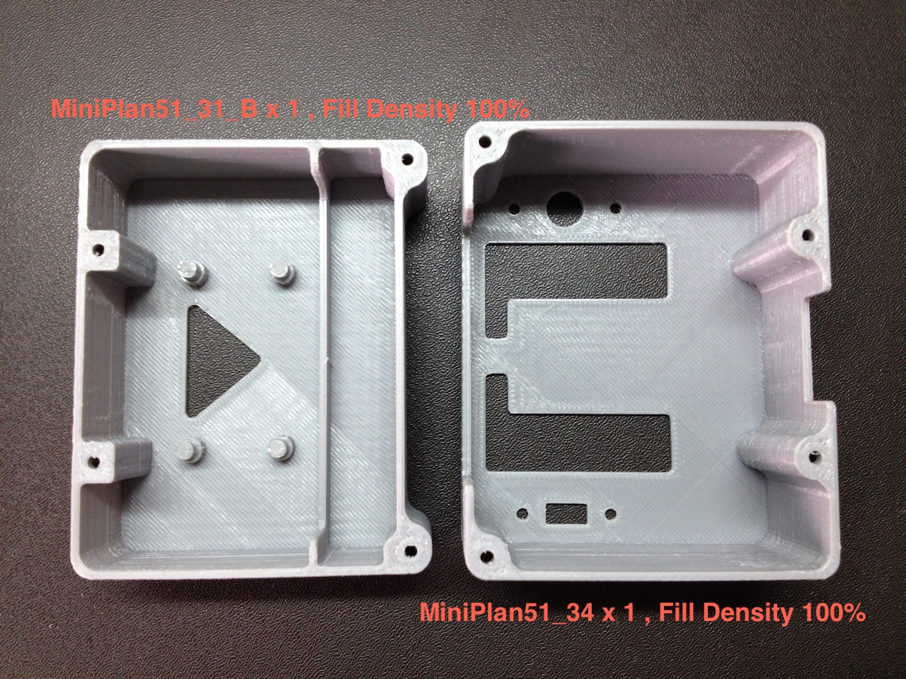
3D Mould Part/DOC/Print Part Group 1B.JPG.JPG
