GeorgeChiou/MiniPlan-V5/3D Mould Part/DOC/Print Part Group 4.JPG

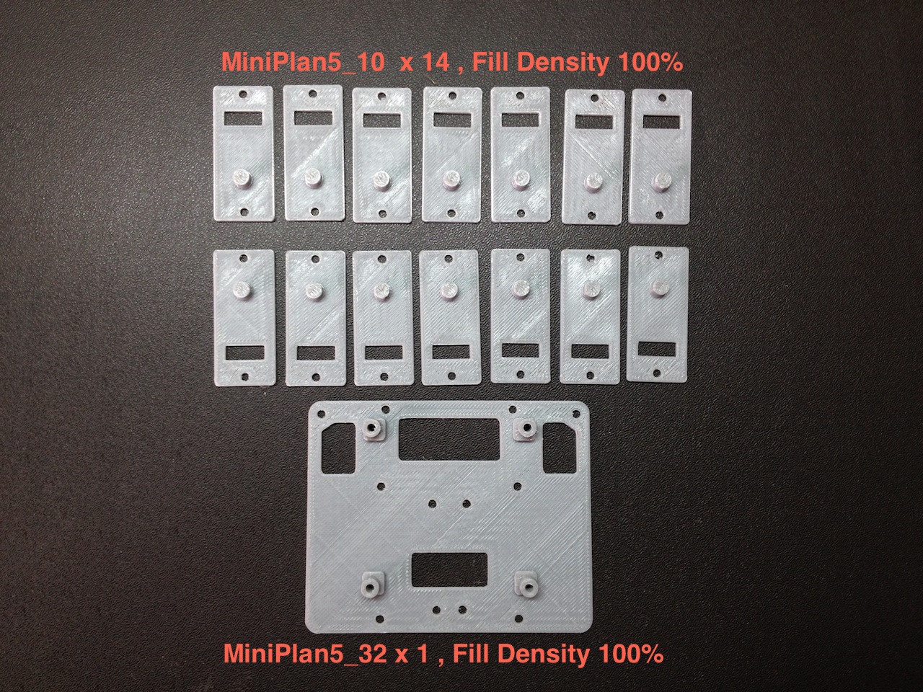
3D Mould Part/DOC/Print Part Group 4.JPG
