GeorgeChiou/MiniPlan-V5/MiniPlan V5.1 Program Instructions/ESP8266 Flasher Win32/Step1.jpg

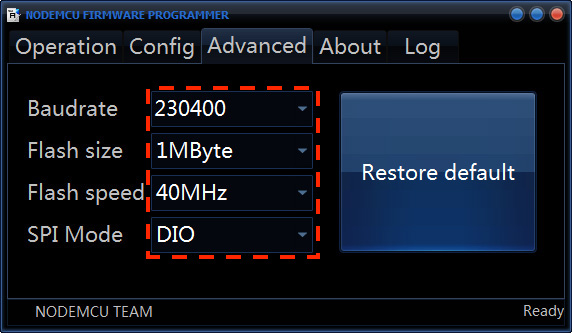
MiniPlan V5.1 Program Instructions/ESP8266 Flasher Win32/Step1.jpg
