GeorgeChiou/MiniPlan-V5/MiniPlan V5.1 Program Instructions/ESP8266 Flasher Win32/Step3.jpg

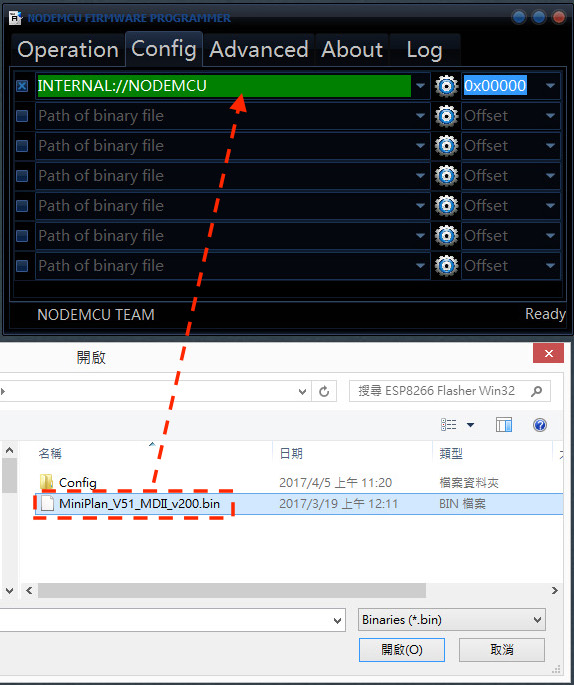
MiniPlan V5.1 Program Instructions/ESP8266 Flasher Win32/Step3.jpg
