GeorgeChiou/MiniPlan-V5/MiniPlan v5.1 HDK 電路說明.pdf

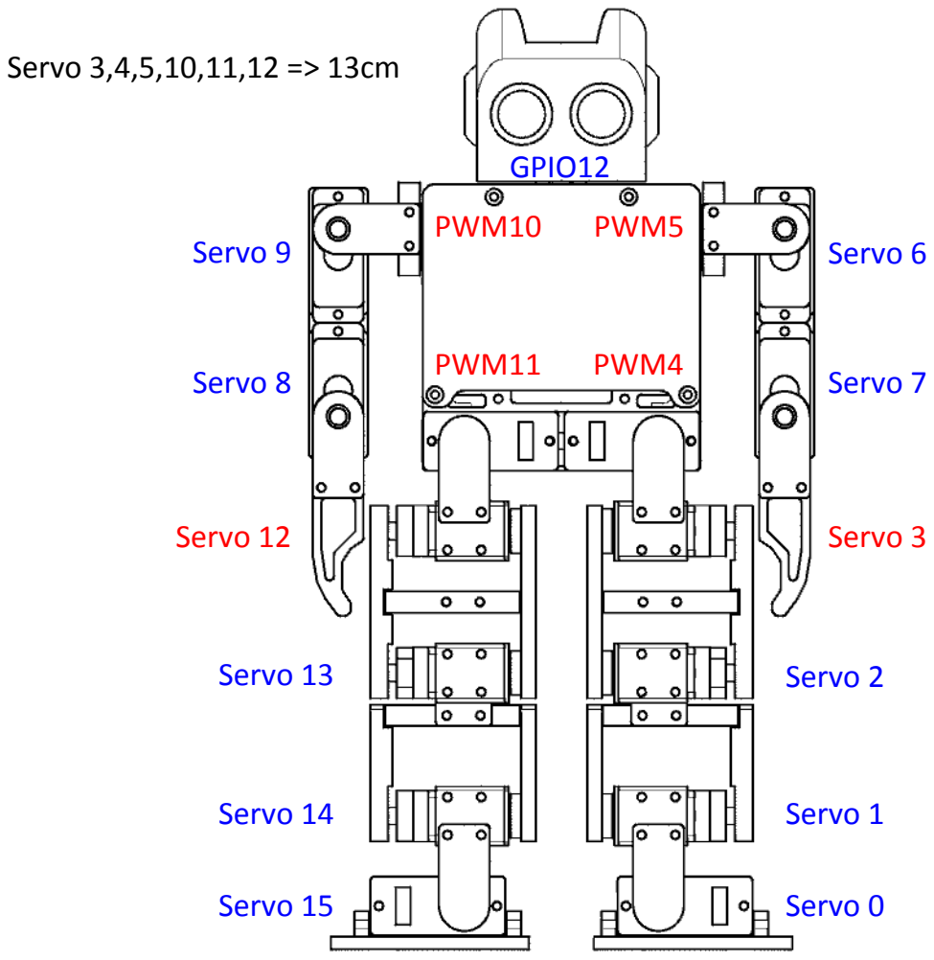
[picture p82: page 1]

GPIO12

Servo

0

Servo

1

Servo

2

Servo

3

Servo

7

Servo

6

PWM4

PWM5

PWM11

PWM10

Servo

8

Servo

9

Servo

15

Servo

14

Servo

13

Servo

12

Servo

3,4,5,10,11,12

=>

13cm

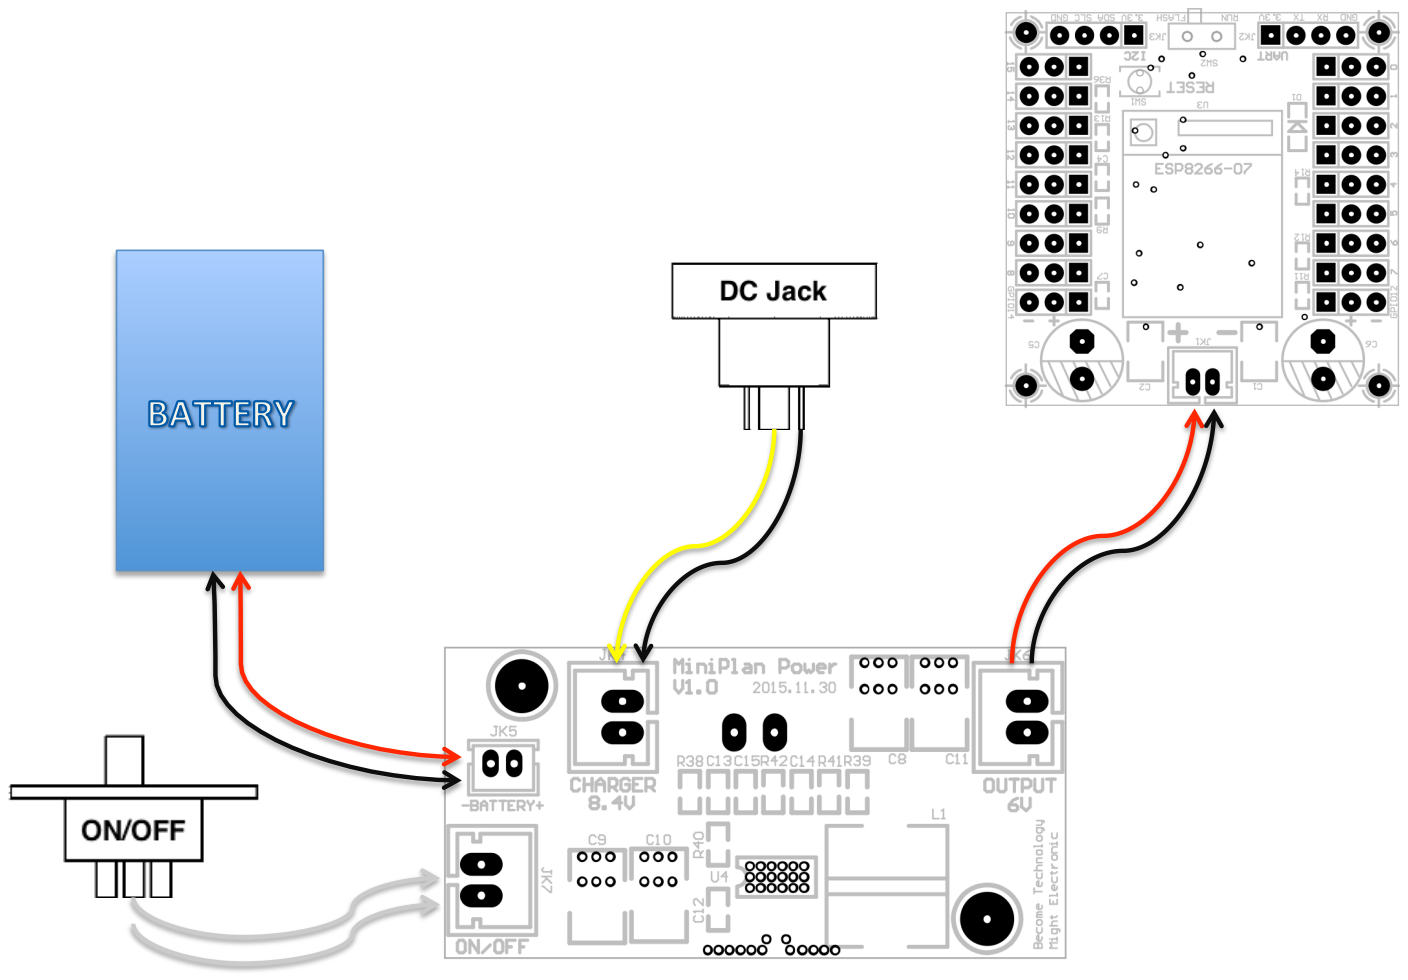
[picture p83: page 2]

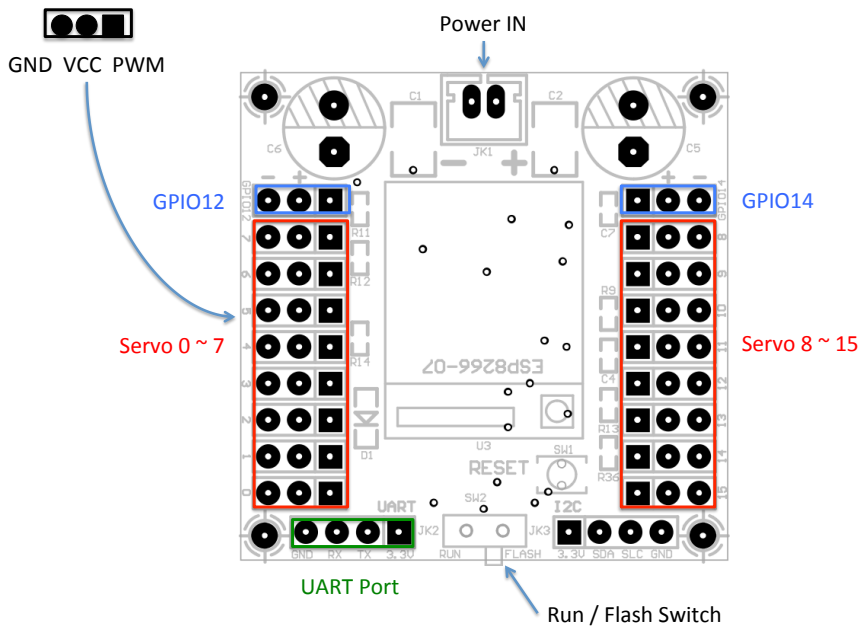
[picture p84: page 3]
Servo; GPIO12; GPIO14; UART; Port; Power; Run; Flash; Switch; GND; VCC; PWM

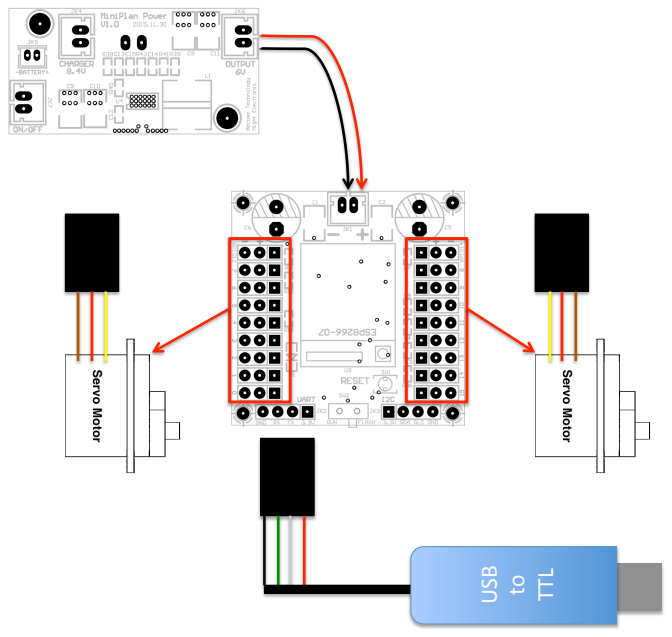
[picture p85: page 4]
USB to; TTL
