GeorgeChiou/MiniPlan-V5/ES8266_to_PCA9685_V300_SCH.pdf

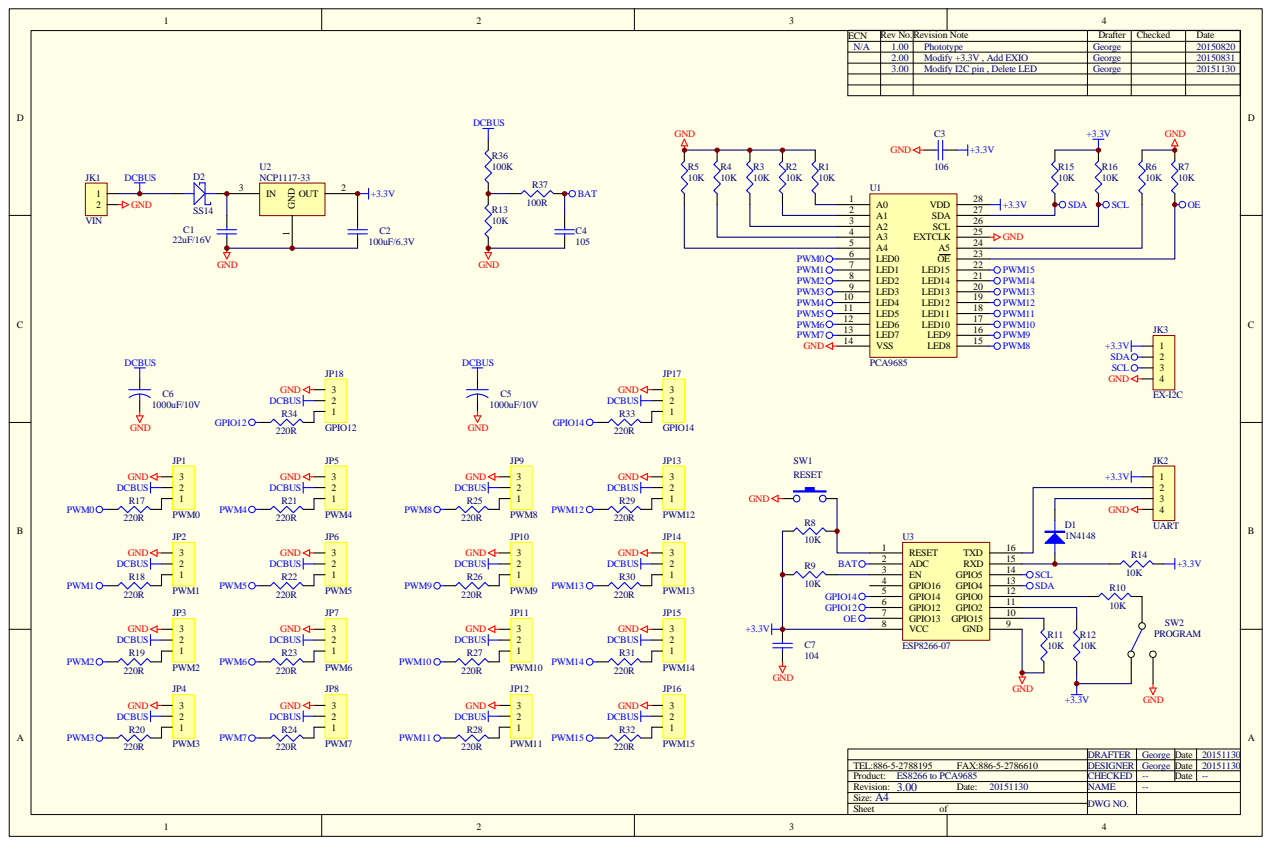
[picture p86: page 1]
